Chiniklas/kinematic_chain/docs/sylink/image.png

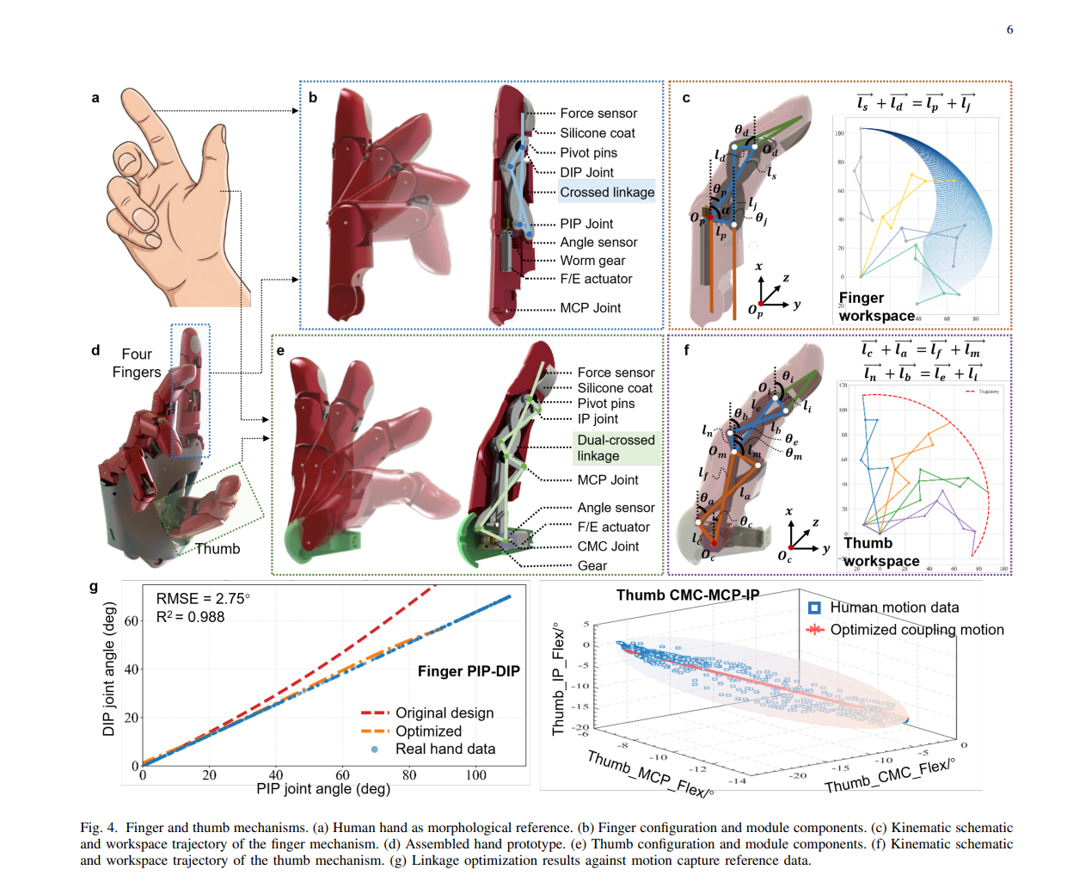
docs/sylink/image.png
