Chiniklas/kinematic_chain/src/co-optimization/config/objectives/little.jpg

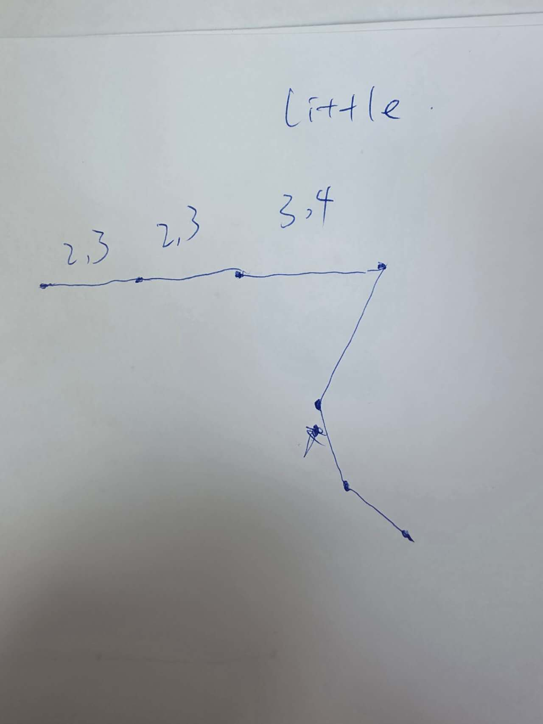
src/co-optimization/config/objectives/little.jpg
