Chiniklas/kinematic_chain/designs/mechanism_2/nominal/artifacts/mechanism/torque/torque_samples.csv

q_deg | input_torque_Nm | input_torque_mNm | body:input_crank_Nm | body:loop_1_coupler_Nm | body:central_body_Nm | body:link_ef_Nm | body:distal_body_Nm | point:joint_b_Nm | point:joint_c_Nm | point:joint_f_Nm | point:joint_g_Nm
0 | -0.00886217412428 | -8.86217412428 | -1.25856304545e-10 | 1.81010883658e-06 | -0.00144303711405 | -0.000202475854404 | -0.00438019748464 | -1.5102758627e-10 | 2.71531428237e-06 | -0.00121485512642 | -0.001626133691
0.5 | -0.00891306620988 | -8.91306620988 | -6.63221682809e-06 | -9.37021541994e-06 | -0.00145834228641 | -0.000201048663018 | -0.00438278547706 | -7.95866019371e-06 | -6.09666293624e-06 | -0.00120629197811 | -0.00163454004991
1 | -0.00896341870421 | -8.96341870421 | -1.32639288644e-05 | -2.05497326343e-05 | -0.00147359110225 | -0.000199607366445 | -0.00438505401288 | -1.59167146373e-05 | -1.49078843142e-05 | -0.00119764419867 | -0.00164288376351
1.5 | -0.00901269168418 | -9.01269168418 | -1.98946306651e-05 | -3.17271150897e-05 | -0.00148872633648 | -0.000198138131604 | -0.00438668432056 | -2.38735567981e-05 | -2.37171158364e-05 | -0.00118882878962 | -0.00165110168752
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
