Chiniklas/kinematic_chain/designs/mechanism_2/nominal/artifacts/mechanism/workspace/workspace_samples.csv

q_deg | max_residual_mm | a_x_mm | a_y_mm | b_x_mm | b_y_mm | c_x_mm | c_y_mm | d_x_mm | d_y_mm | e_x_mm | e_y_mm | f_x_mm | f_y_mm | g_x_mm | g_y_mm | h_x_mm | h_y_mm
0 | 1.00750335e-06 | 0 | 0 | 0 | 31 | 53.916595 | 27.999876 | 54 | 0 | 65.518519 | 7.957621 | 94.718773 | 1.076843 | 103.914329 | 27.523804 | 150.932098 | 10.514118
0.5 | 1.349514633e-08 | 0 | 0 | 0.2705226002 | 30.99881962 | 54.18715574 | 27.99937451 | 54 | 0 | 65.518519 | 7.957621 | 94.63182167 | 0.7177585297 | 104.1779549 | 27.0402079 | 150.9655731 | 9.407318576
1 | 1.355390111e-08 | 0 | 0 | 0.5410245992 | 30.99527855 | 54.45768142 | 27.99625917 | 54 | 0 | 65.518519 | 7.957621 | 94.54083115 | 0.3612140897 | 104.4368794 | 26.55411827 | 150.9853744 | 8.299321162
1.5 | 1.361586754e-08 | 0 | 0 | 0.8114853972 | 30.98937707 | 54.72815183 | 27.99053045 | 54 | 0 | 65.518519 | 7.957621 | 94.44587213 | 0.007259887298 | 104.6910835 | 26.06557229 | 150.9914609 | 7.190322661
2 | 1.36813938e-08 | 0 | 0 | 1.081884397 | 30.98111564 | 54.99854639 | 27.98218907 | 54 | 0 | 65.518519 | 7.957621 | 94.34701495 | -0.344054839 | 104.9405483 | 25.57460741 | 150.9837949 | 6.080520042
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
