Chiniklas/kinematic_chain/designs/mechanism_2/nominal/artifacts/combined/fingers/index/combined_workspace_samples.csv

finger | q_deg | curl_progress | h_x_mm | h_y_mm | hand_mcp_x_mm | hand_mcp_y_mm | hand_pip_x_mm | hand_pip_y_mm | hand_dip_x_mm | hand_dip_y_mm | hand_tip_x_mm | hand_tip_y_mm | distal_start_x_mm | distal_start_y_mm | distal_end_x_mm | distal_end_y_mm | r4_x_mm | r4_y_mm | rod_length_mm | rod_error_mm | perpendicular_deviation_deg | mechanism_residual_mm
index | 0.0 | 0.0 | 96.932098 | 10.514118 | 0.0 | -2.0 | 40.0 | -2.0 | 65.0 | -2.0 | 90.0 | -2.0 | 65.0 | -2.0 | 90.0 | -2.0 | 77.5 | -2.0 | 28.0 | 4.88702567821424 | 57.21878387128254 | 1.0075033500811514e-06
index | 0.5 | 0.007633587786259542 | 96.96557307365543 | 9.407318575703622 | 0.0 | -2.0 | 39.999248798505036 | -2.24514394810717 | 64.99641564020598 | -2.621507984868039 | 89.99206687823877 | -3.087790288445934 | 64.99641564020598 | -2.621507984868039 | 89.99206687823877 | -3.087790288445934 | 77.49424125922238 | -2.8546491366569864 | 28.0 | 4.989380390638608 | 56.730843304965525 | 1.3495146333752928e-08
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
