Chiniklas/kinematic_chain/designs/mechanism_2/nominal/artifacts/combined/fingers/little/combined_workspace_samples.csv

finger | q_deg | curl_progress | h_x_mm | h_y_mm | hand_mcp_x_mm | hand_mcp_y_mm | hand_pip_x_mm | hand_pip_y_mm | hand_dip_x_mm | hand_dip_y_mm | hand_tip_x_mm | hand_tip_y_mm | distal_start_x_mm | distal_start_y_mm | distal_end_x_mm | distal_end_y_mm | r4_x_mm | r4_y_mm | rod_length_mm | rod_error_mm | perpendicular_deviation_deg | mechanism_residual_mm
little | 0.0 | 0.0 | 96.932098 | 10.514118 | 0.0 | -2.0 | 34.0 | -2.0 | 57.0 | -2.0 | 80.0 | -2.0 | 57.0 | -2.0 | 80.0 | -2.0 | 68.5 | -2.0 | 28.0 | 3.0642454600063935 | 66.24376121835917 | 1.0075033500811514e-06
little | 0.5 | 0.007633587786259542 | 96.96557307365543 | 9.407318575703622 | 0.0 | -2.0 | 33.99872507374635 | -2.2944373614393214 | 56.99629983025596 | -2.6284363416054677 | 79.99212567188638 | -3.066607382869641 | 56.99629983025596 | -2.6284363416054677 | 79.99212567188638 | -3.066607382869641 | 68.49421275107117 | -2.8475218622375547 | 28.0 | 2.996765521225335 | 65.62005078098242 | 1.3495146333752928e-08
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
