Chiniklas/kinematic_chain/designs/mechanism_2/nominal/artifacts/combined/fingers/middle/combined_workspace_samples.csv

finger | q_deg | curl_progress | h_x_mm | h_y_mm | hand_mcp_x_mm | hand_mcp_y_mm | hand_pip_x_mm | hand_pip_y_mm | hand_dip_x_mm | hand_dip_y_mm | hand_tip_x_mm | hand_tip_y_mm | distal_start_x_mm | distal_start_y_mm | distal_end_x_mm | distal_end_y_mm | r4_x_mm | r4_y_mm | rod_length_mm | rod_error_mm | perpendicular_deviation_deg | mechanism_residual_mm
middle | 0.0 | 0.0 | 96.932098 | 10.514118 | 0.0 | -2.0 | 49.0 | -2.0 | 76.0 | -2.0 | 103.0 | -2.0 | 76.0 | -2.0 | 103.0 | -2.0 | 89.5 | -2.0 | 28.0 | 13.445302133004343 | 30.705952228880232 | 1.0075033500811514e-06
middle | 0.5 | 0.007633587786259542 | 96.96557307365543 | 9.407318575703622 | 0.0 | -2.0 | 48.999404638431415 | -2.2415472609362204 | 75.99618020625371 | -2.658810895384777 | 102.99128010729812 | -3.173185595999241 | 75.99618020625371 | -2.658810895384777 | 102.99128010729812 | -3.173185595999241 | 89.49373015677591 | -2.915998245692009 | 28.0 | 13.588456916241924 | 30.13756429501541 | 1.3495146333752928e-08
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
