Chiniklas/kinematic_chain/designs/mechanism_2/nominal/artifacts/combined/fingers/ring/combined_workspace_samples.csv

finger | q_deg | curl_progress | h_x_mm | h_y_mm | hand_mcp_x_mm | hand_mcp_y_mm | hand_pip_x_mm | hand_pip_y_mm | hand_dip_x_mm | hand_dip_y_mm | hand_tip_x_mm | hand_tip_y_mm | distal_start_x_mm | distal_start_y_mm | distal_end_x_mm | distal_end_y_mm | r4_x_mm | r4_y_mm | rod_length_mm | rod_error_mm | perpendicular_deviation_deg | mechanism_residual_mm
ring | 0.0 | 0.0 | 96.932098 | 10.514118 | 0.0 | -2.0 | 44.0 | -2.0 | 70.0 | -2.0 | 96.0 | -2.0 | 70.0 | -2.0 | 96.0 | -2.0 | 83.0 | -2.0 | 28.0 | 9.27284047166982 | 48.06911766849675 | 1.0075033500811514e-06
ring | 0.5 | 0.007633587786259542 | 96.96557307365543 | 9.407318575703622 | 0.0 | -2.0 | 43.99940603198138 | -2.228623780130022 | 69.99749515397887 | -2.543841172853755 | 95.99290760251141 | -3.0322381739498736 | 69.99749515397887 | -2.543841172853755 | 95.99290760251141 | -3.0322381739498736 | 82.99520137824514 | -2.7880396734018142 | 28.0 | 9.455511650845011 | 47.80451143116388 | 1.3495146333752928e-08
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
