Chiniklas/kinematic_chain/designs/mechanism_2/nominal/artifacts/combined/combined_abstraction.png

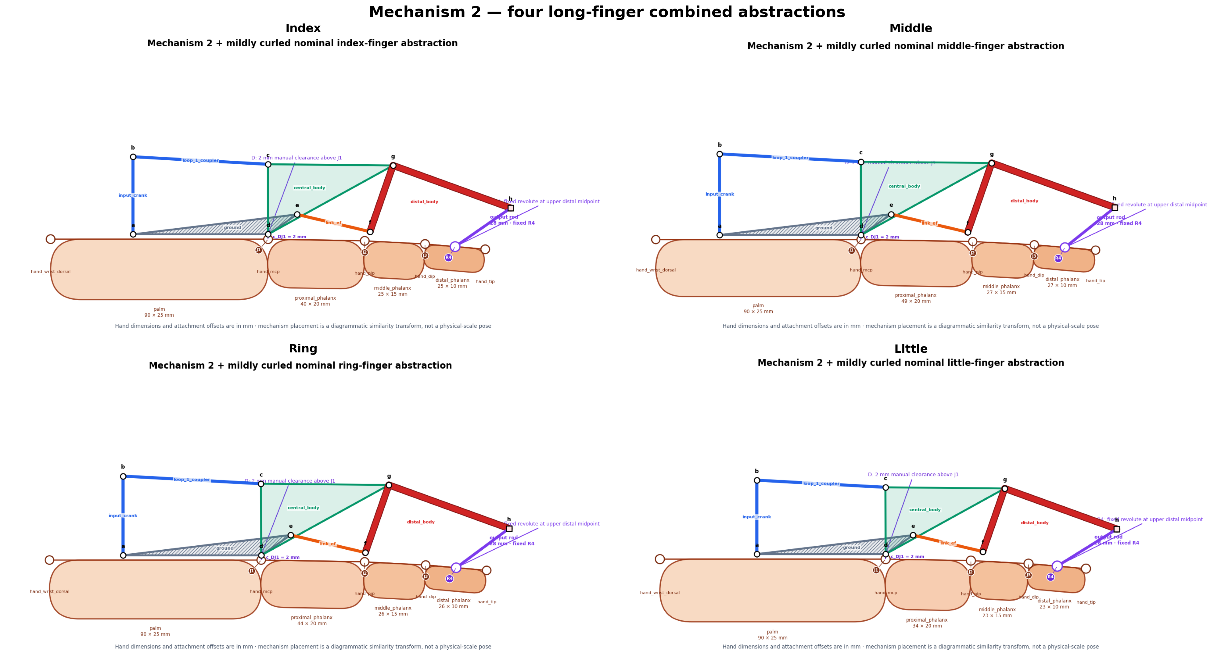
designs/mechanism_2/nominal/artifacts/combined/combined_abstraction.png
