Chiniklas/kinematic_chain/designs/mechanism_2/nominal/artifacts/combined/combined_workspace_report.png

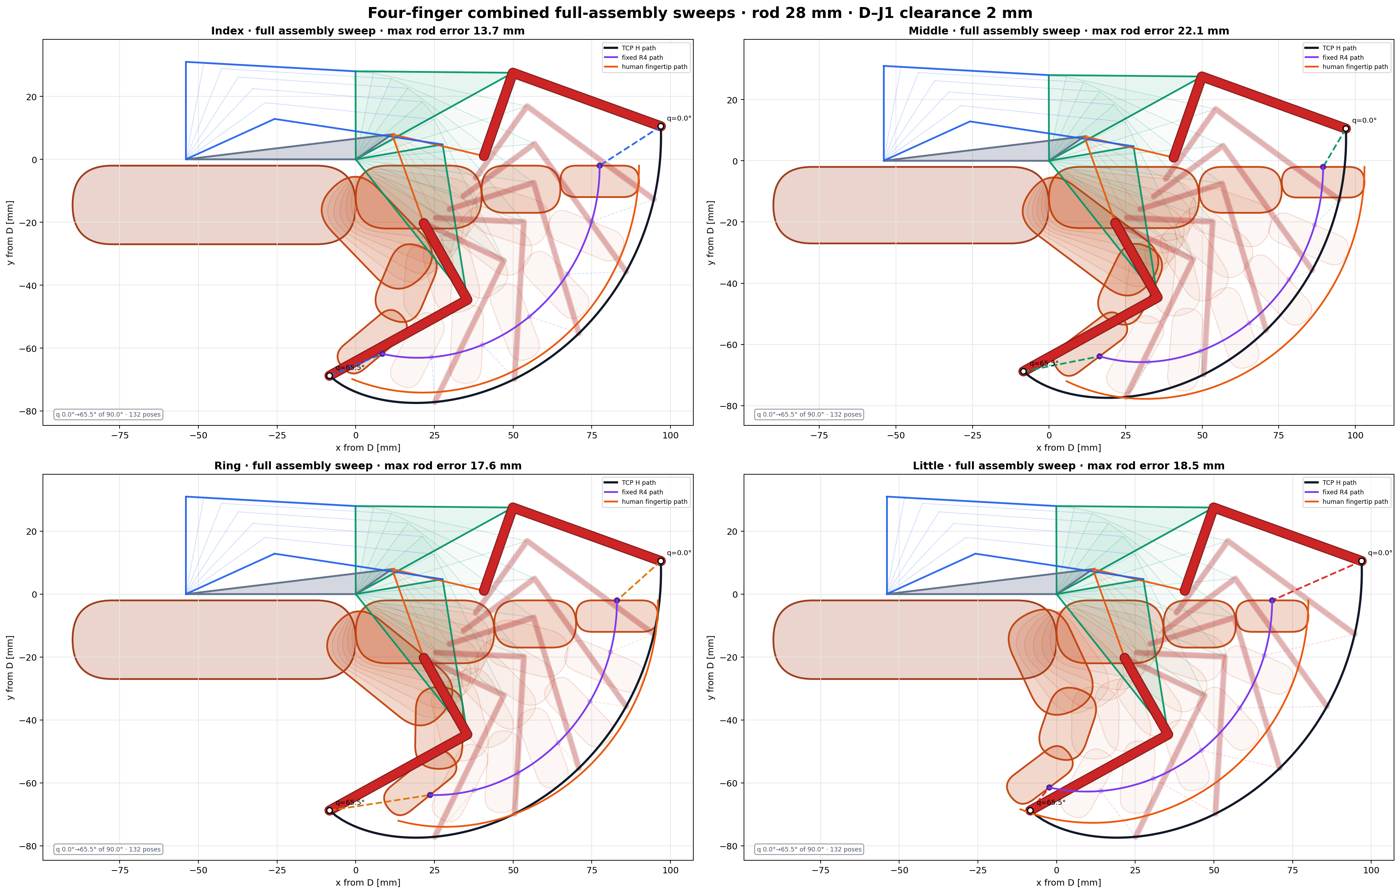
designs/mechanism_2/nominal/artifacts/combined/combined_workspace_report.png
