Chiniklas/kinematic_chain/designs/mechanism_2/nominal/artifacts/combined/fingers/index/combined_abstraction.png

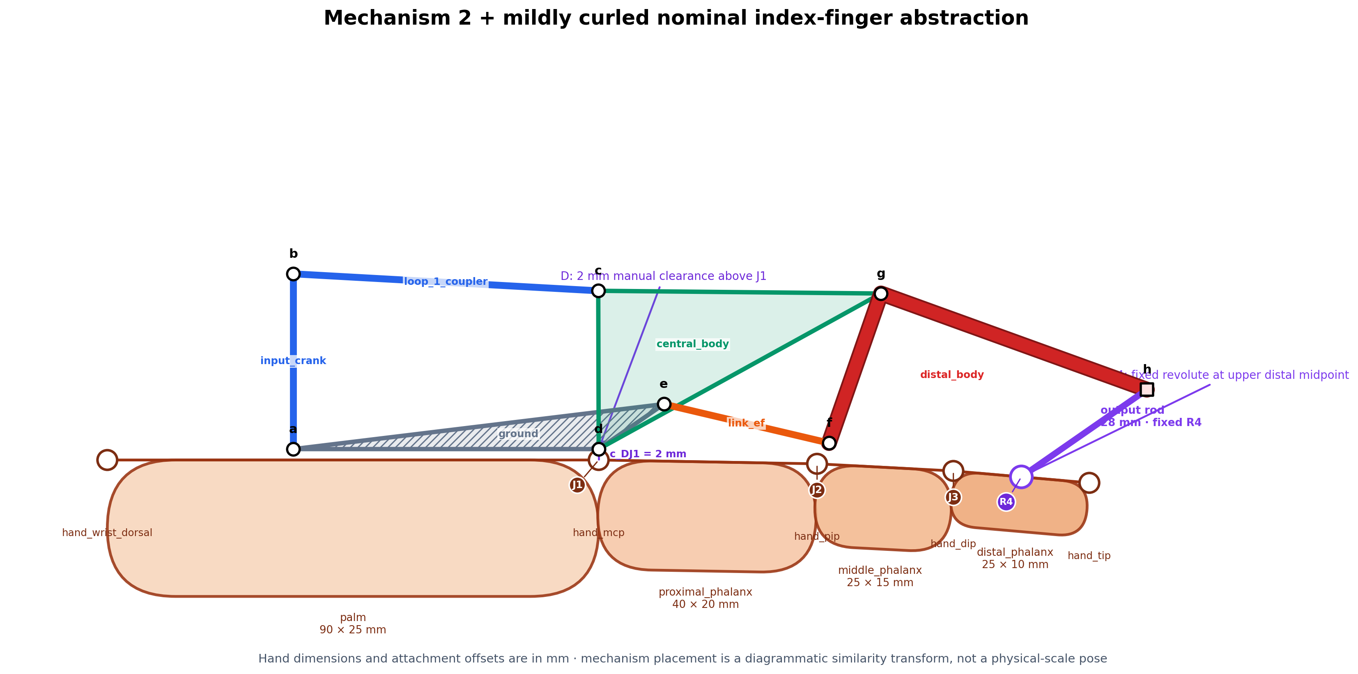
designs/mechanism_2/nominal/artifacts/combined/fingers/index/combined_abstraction.png
