Chiniklas/kinematic_chain/designs/mechanism_2/nominal/artifacts/combined/fingers/little/combined_abstraction.png

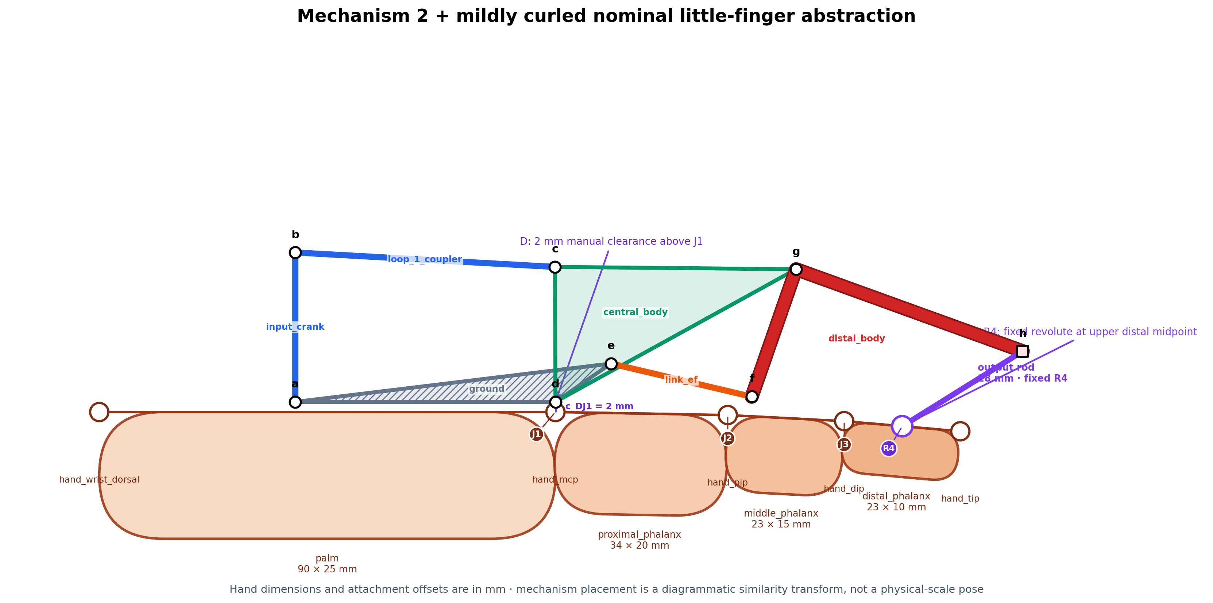
designs/mechanism_2/nominal/artifacts/combined/fingers/little/combined_abstraction.png
