Chiniklas/kinematic_chain/designs/mechanism_2/nominal/artifacts/mechanism/abstraction.png

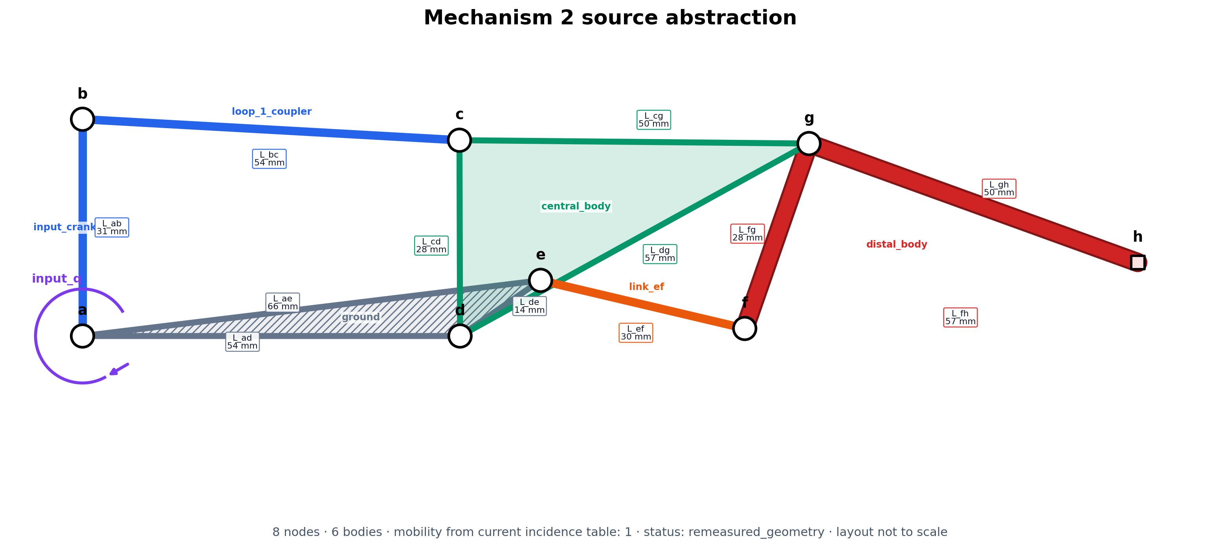
designs/mechanism_2/nominal/artifacts/mechanism/abstraction.png
