Chiniklas/kinematic_chain/designs/mechanism_2/nominal/artifacts/mechanism/torque/torque_report.png

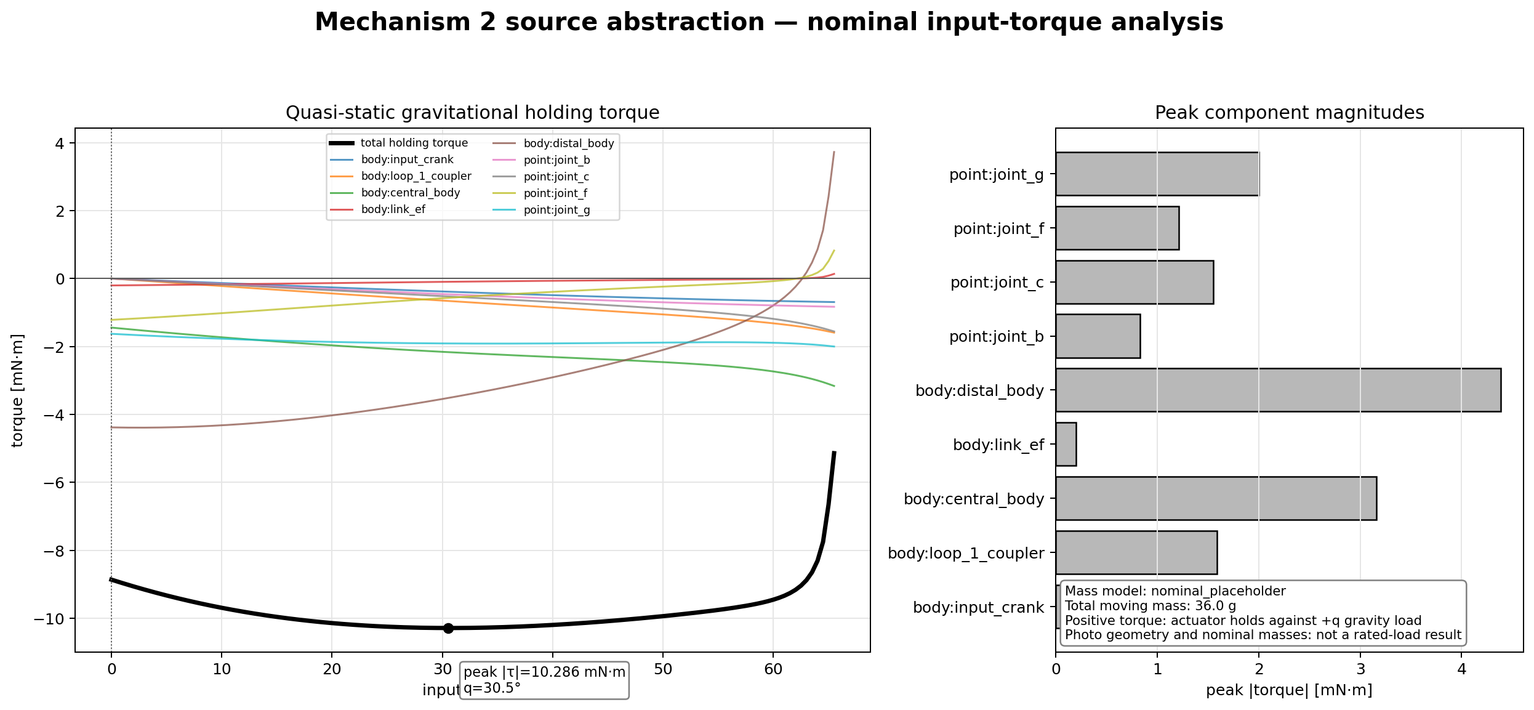
designs/mechanism_2/nominal/artifacts/mechanism/torque/torque_report.png
