Chiniklas/kinematic_chain/designs/mechanism_2/nominal/artifacts/mechanism/workspace/workspace_report.png

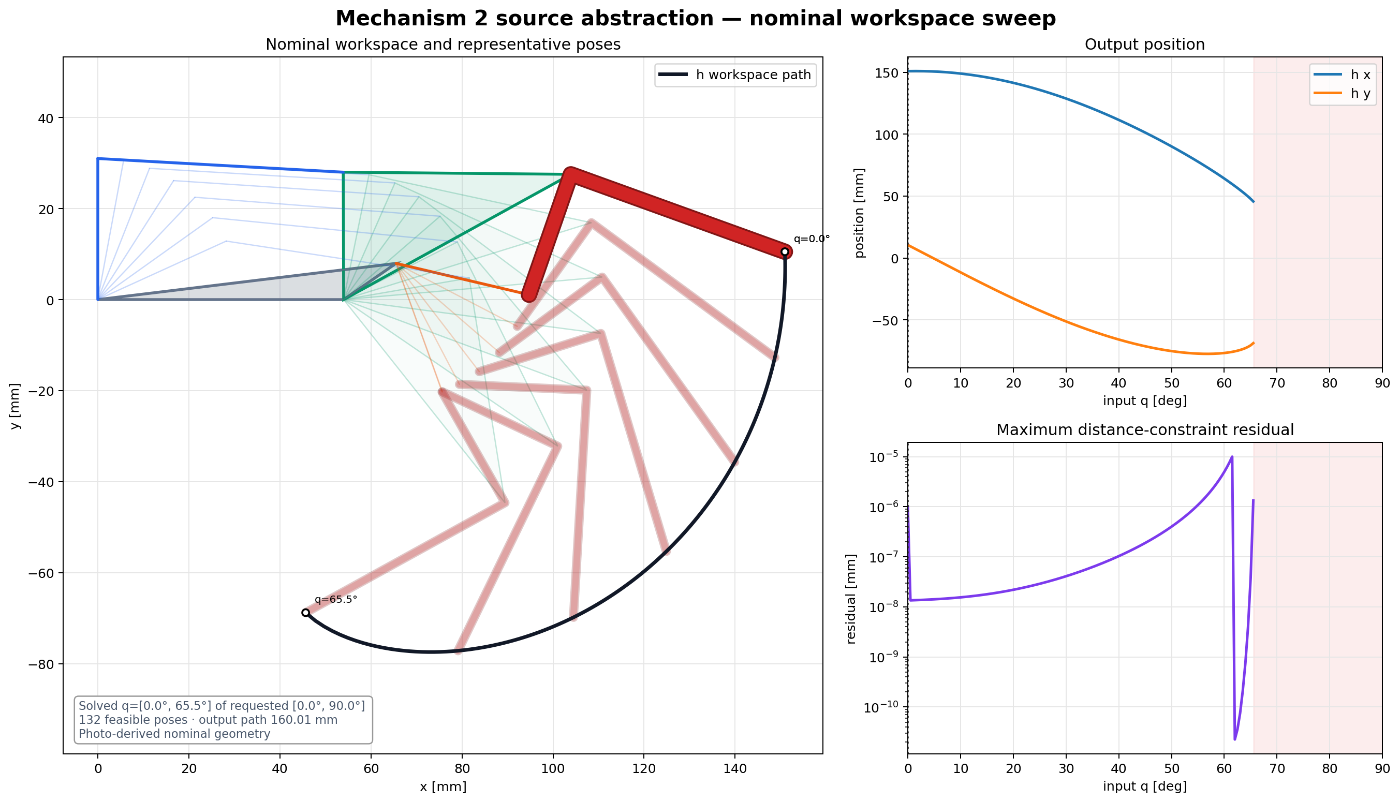
designs/mechanism_2/nominal/artifacts/mechanism/workspace/workspace_report.png
