Chiniklas/kinematic_chain/designs/mechanism_2/nominal/sources/abstraction.jpg

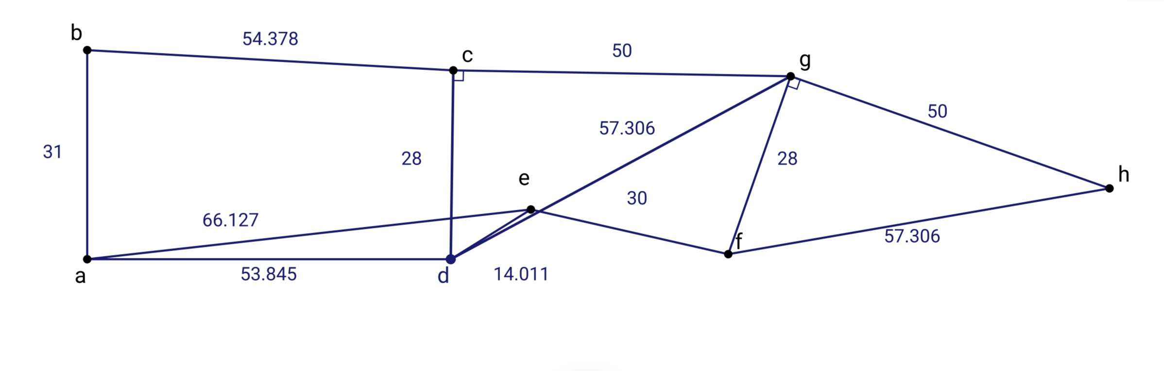
designs/mechanism_2/nominal/sources/abstraction.jpg
