Chiniklas/kinematic_chain/docs/candidates/compare_short_vs_long.gif

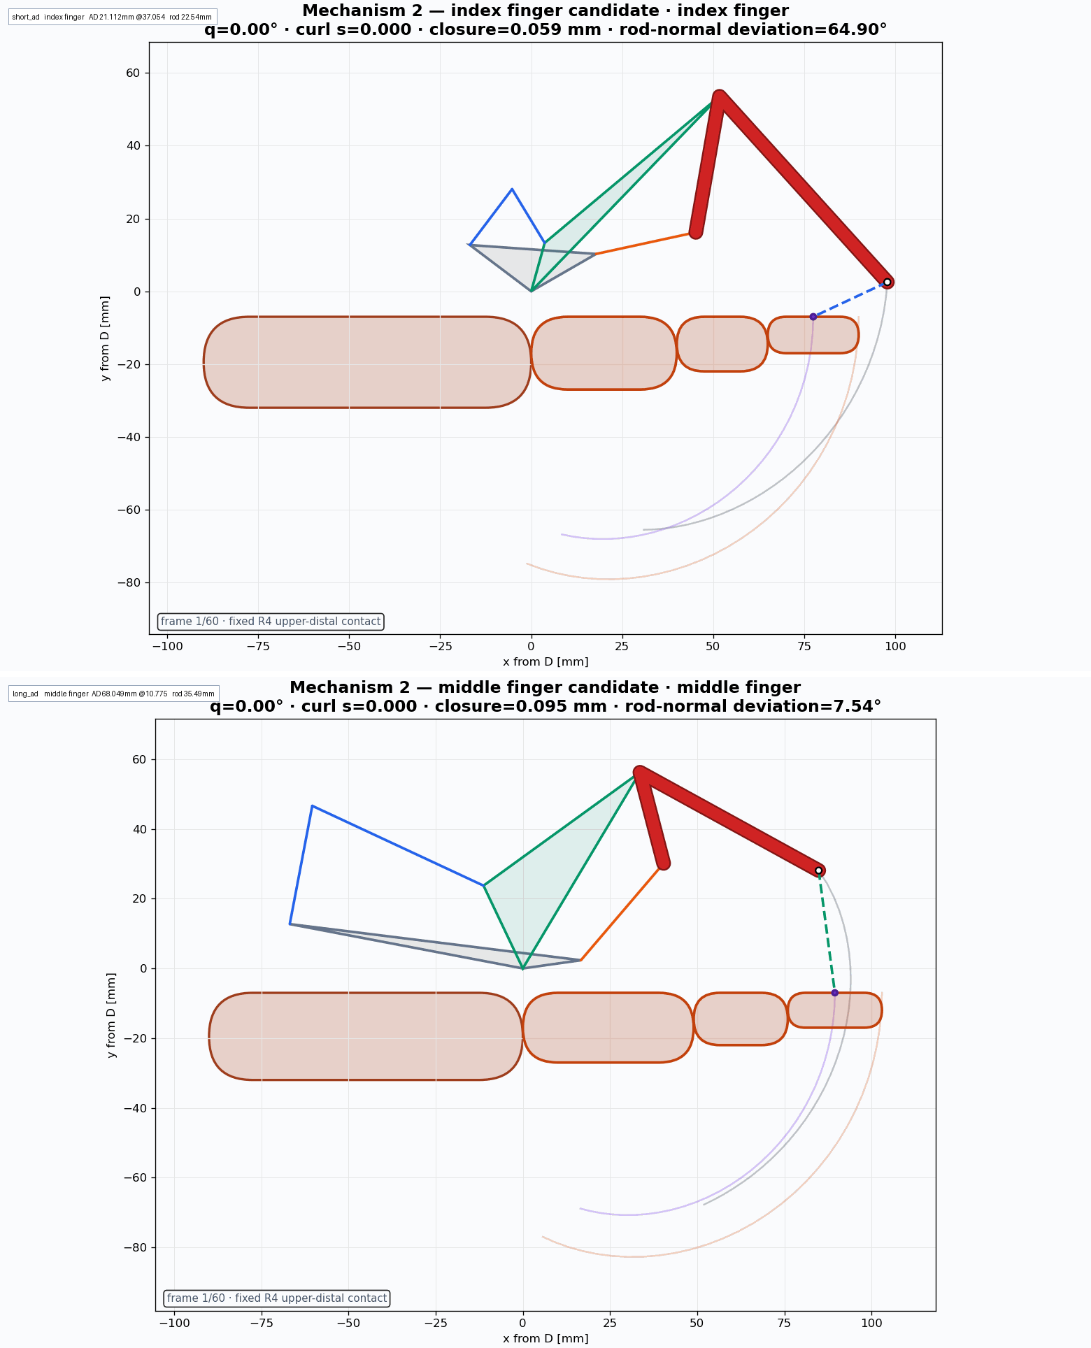
docs/candidates/compare_short_vs_long.gif
