Chiniklas/kinematic_chain/docs/candidates/index_finger_tilted_v2/design_animation.gif

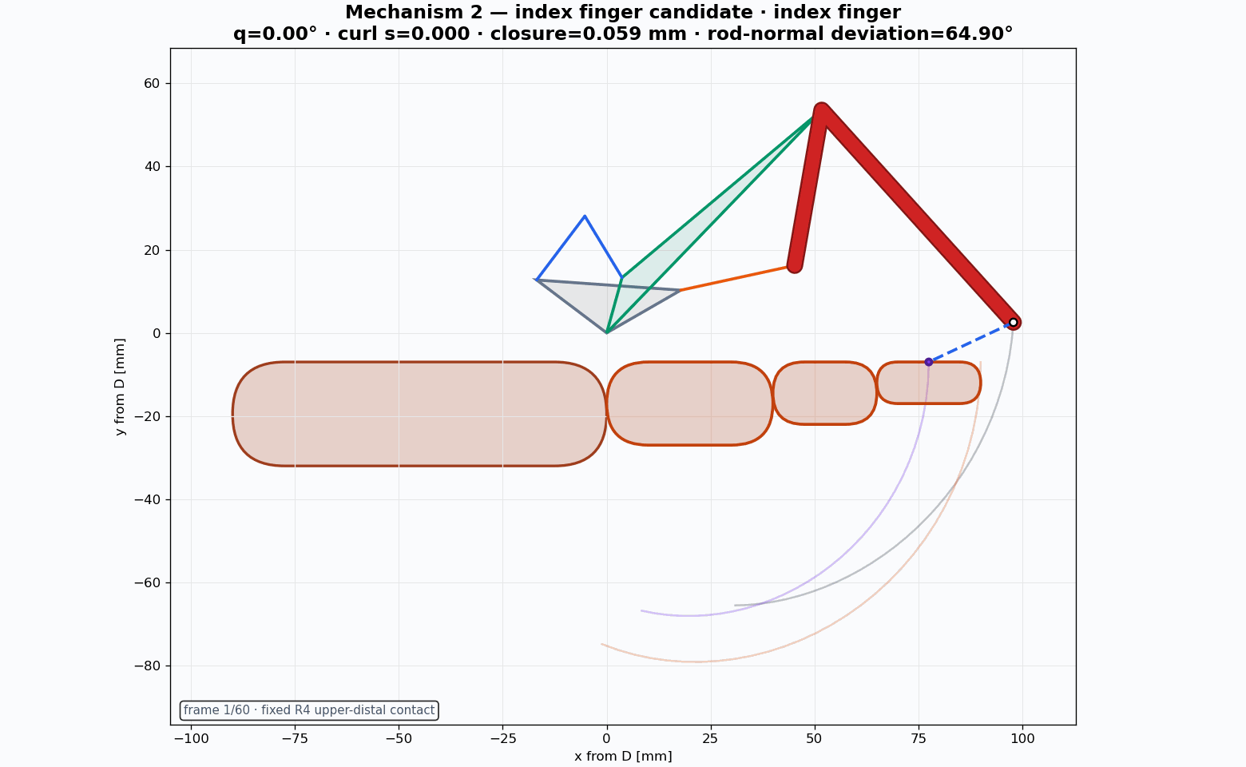
docs/candidates/index_finger_tilted_v2/design_animation.gif
