Chiniklas/kinematic_chain/docs/candidates/index_finger_v1/abstraction.png

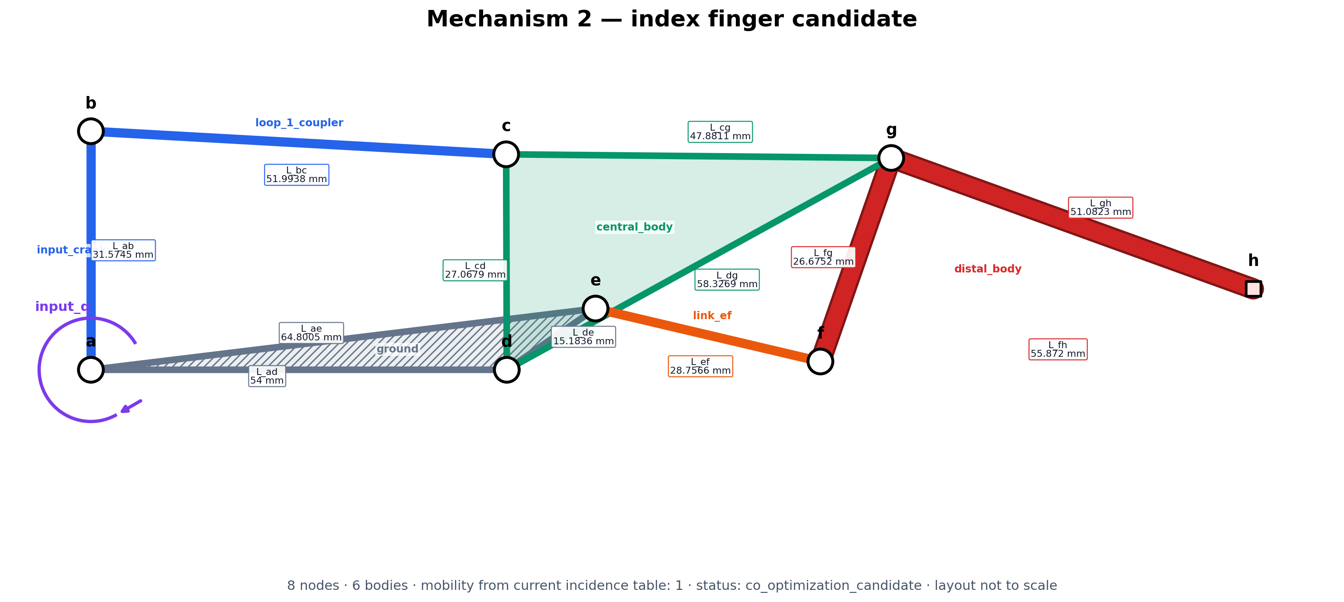
docs/candidates/index_finger_v1/abstraction.png
