Chiniklas/kinematic_chain/docs/candidates/index_finger_v1/combined_workspace_report.png

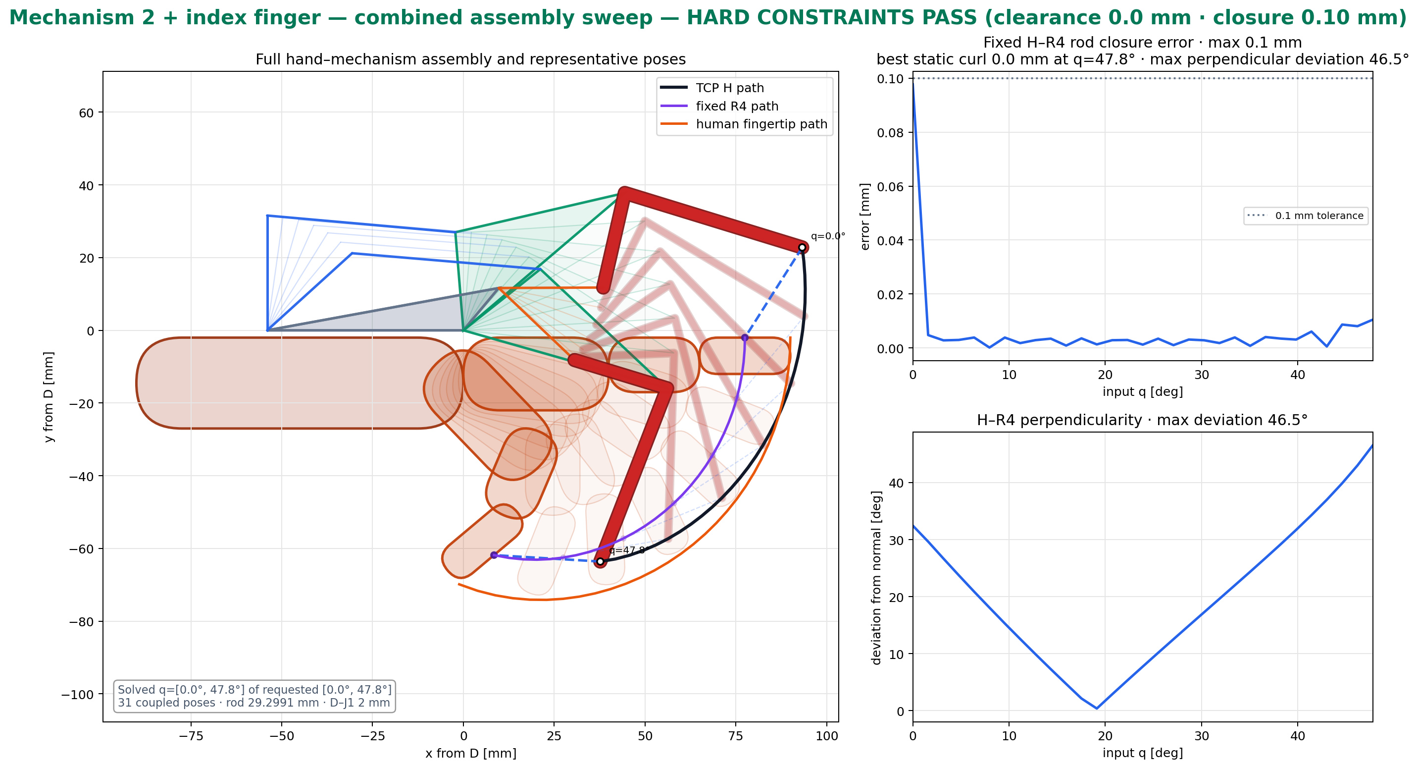
docs/candidates/index_finger_v1/combined_workspace_report.png
