Chiniklas/kinematic_chain/docs/candidates/index_finger_v1/design_animation.gif

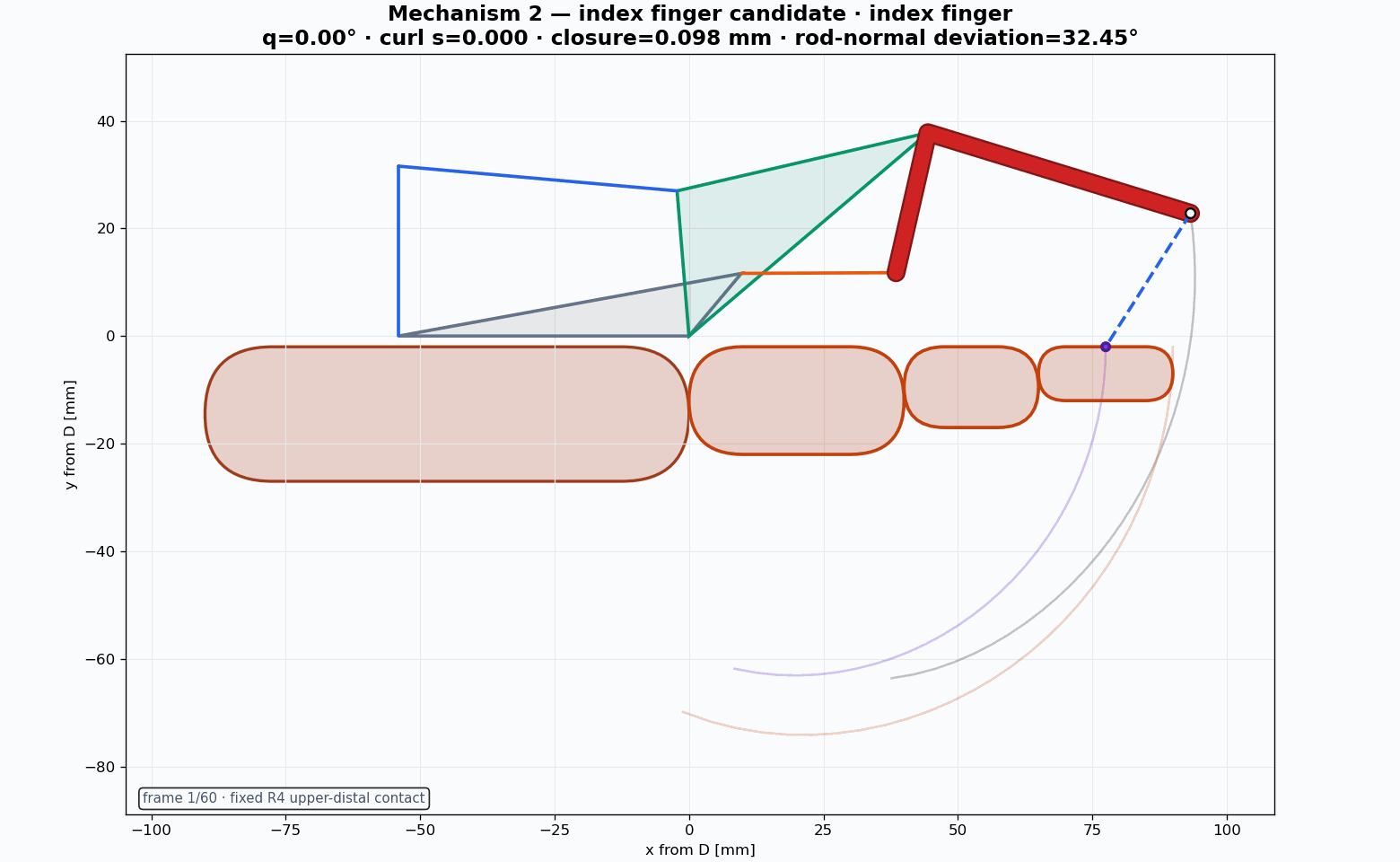
docs/candidates/index_finger_v1/design_animation.gif
