Chiniklas/kinematic_chain/docs/candidates/middle_finger_long_ad/design_animation.gif

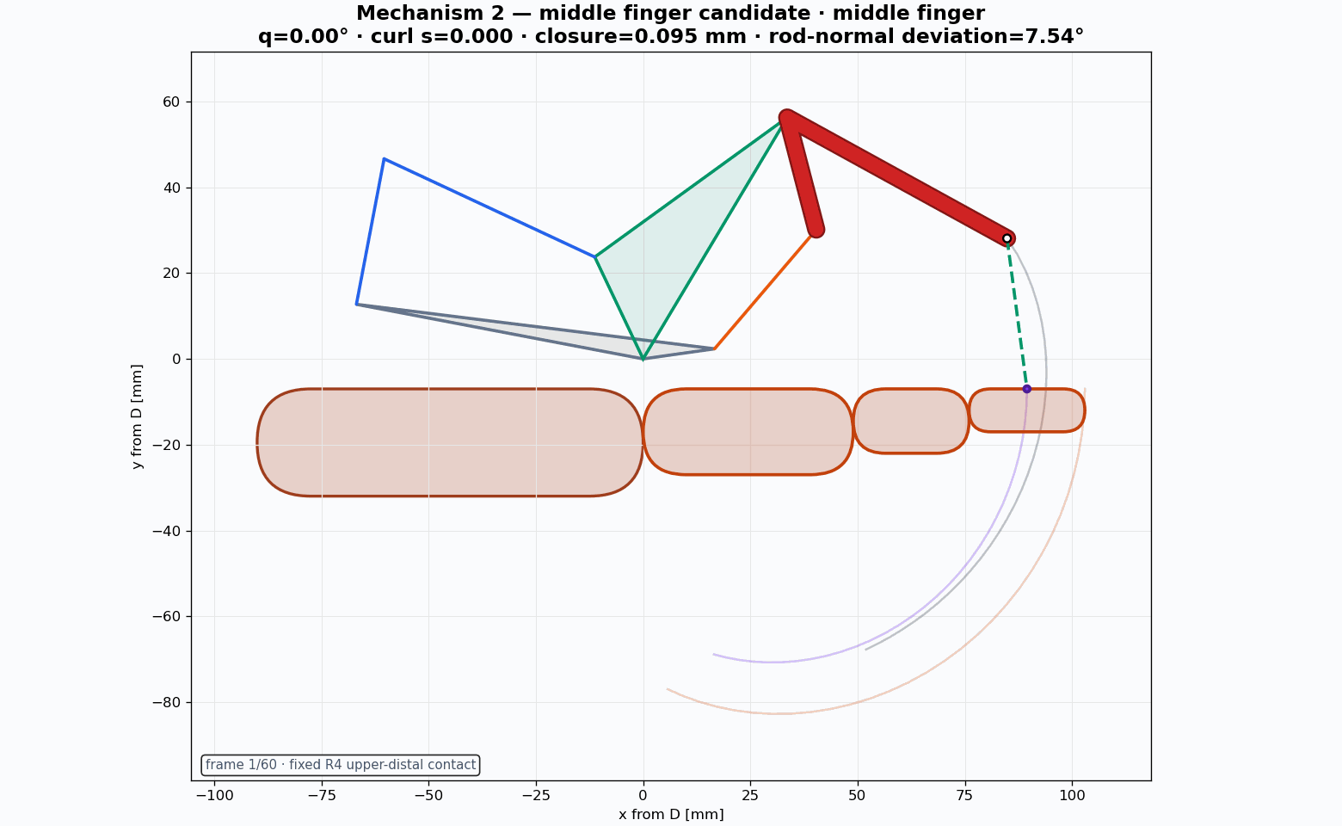
docs/candidates/middle_finger_long_ad/design_animation.gif
