Chiniklas/kinematic_chain/docs/candidates/thumb_direct/preview_exploded.png

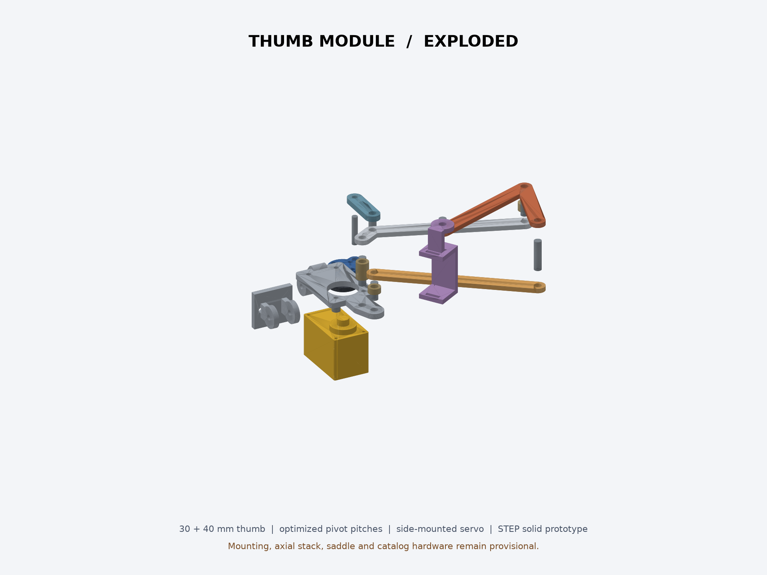
docs/candidates/thumb_direct/preview_exploded.png
