Chiniklas/kinematic_chain/docs/candidates/thumb_direct/preview_full_curl.png

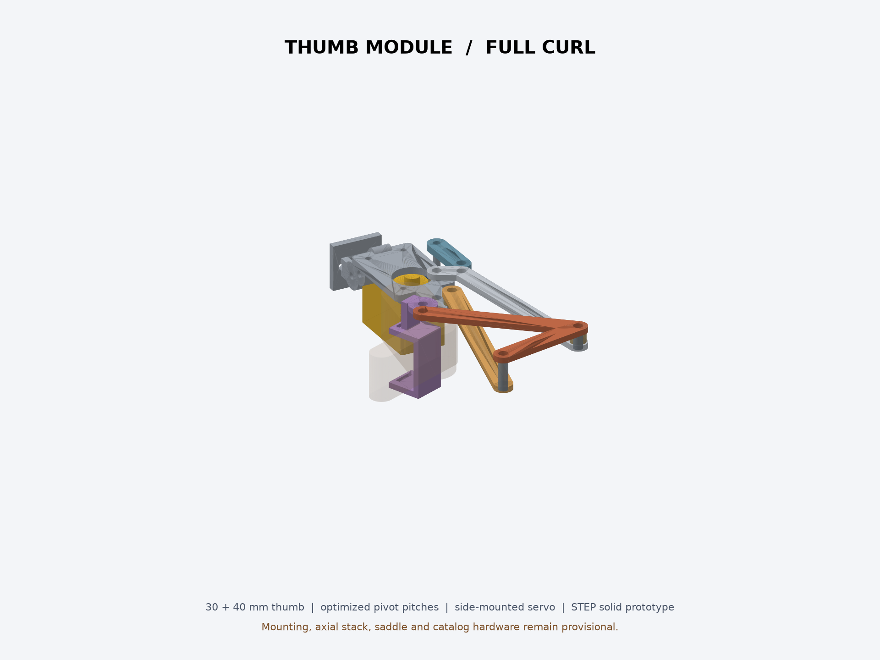
docs/candidates/thumb_direct/preview_full_curl.png
