Chiniklas/kinematic_chain/docs/candidates/thumb_direct/preview_straight.png

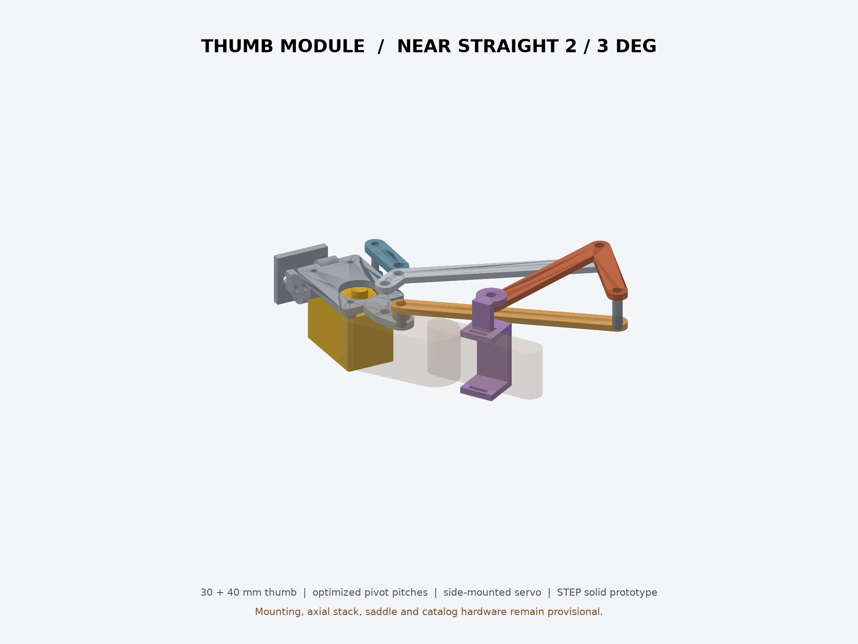
docs/candidates/thumb_direct/preview_straight.png
