Chiniklas/kinematic_chain/docs/candidates/thumb_direct/thumb_direct.gif

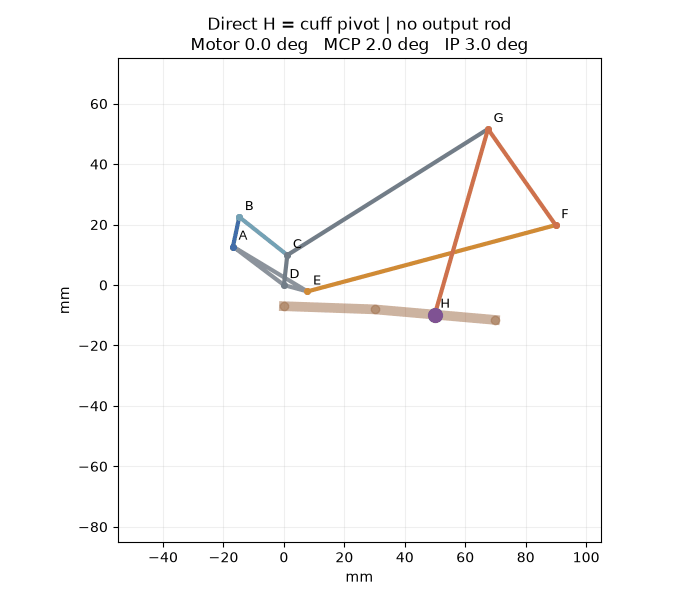
docs/candidates/thumb_direct/thumb_direct.gif
