Chiniklas/kinematic_chain/src/co-optimization/config/objectives/index.jpg

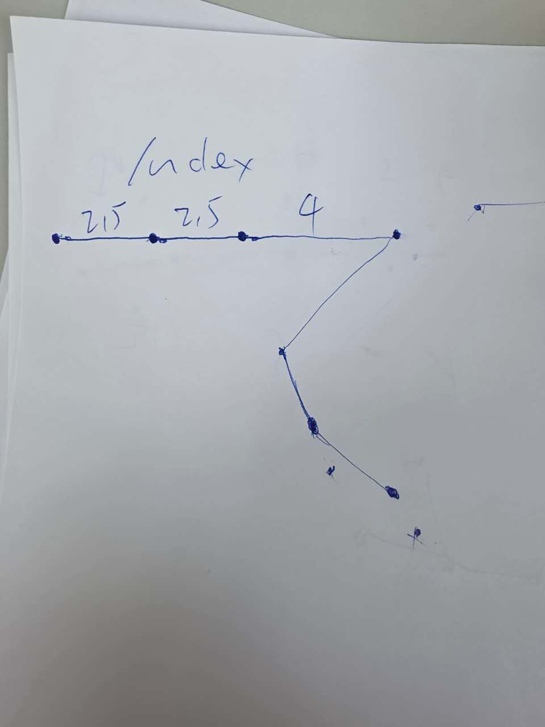
src/co-optimization/config/objectives/index.jpg
