Chiniklas/kinematic_chain/src/co-optimization/config/objectives/middle.jpg

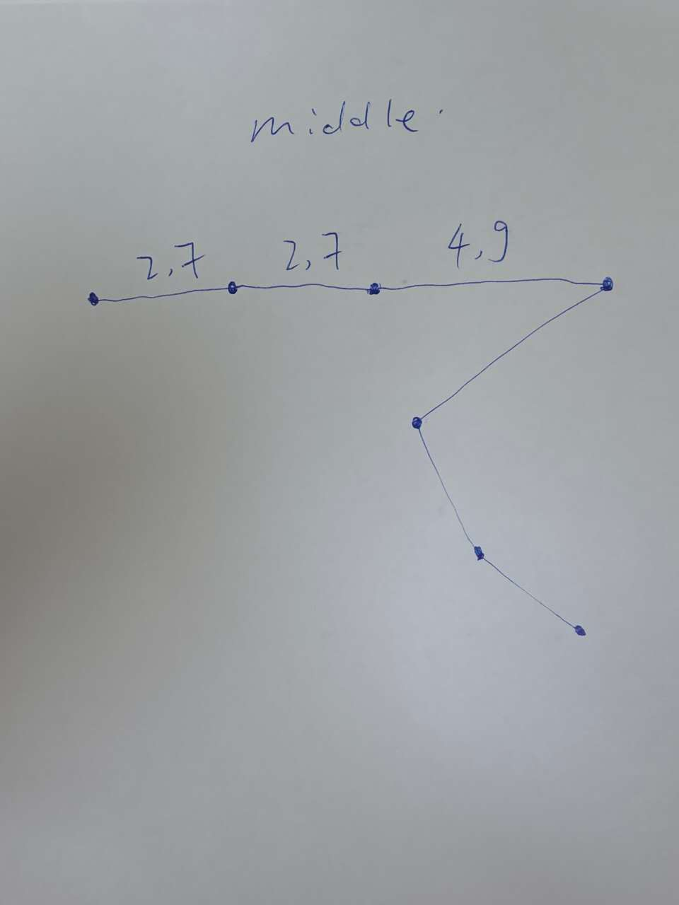
src/co-optimization/config/objectives/middle.jpg
