Chiniklas/kinematic_chain/src/co-optimization/config/objectives/ring.jpg

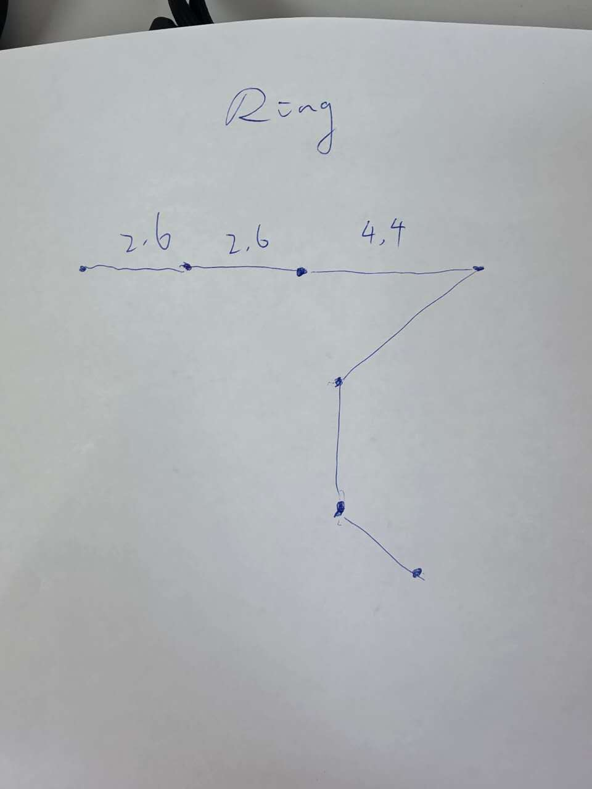
src/co-optimization/config/objectives/ring.jpg
