Chiniklas/kinematic_chain/docs/candidates/thumb_direct/parts/motor_standoff_3.step

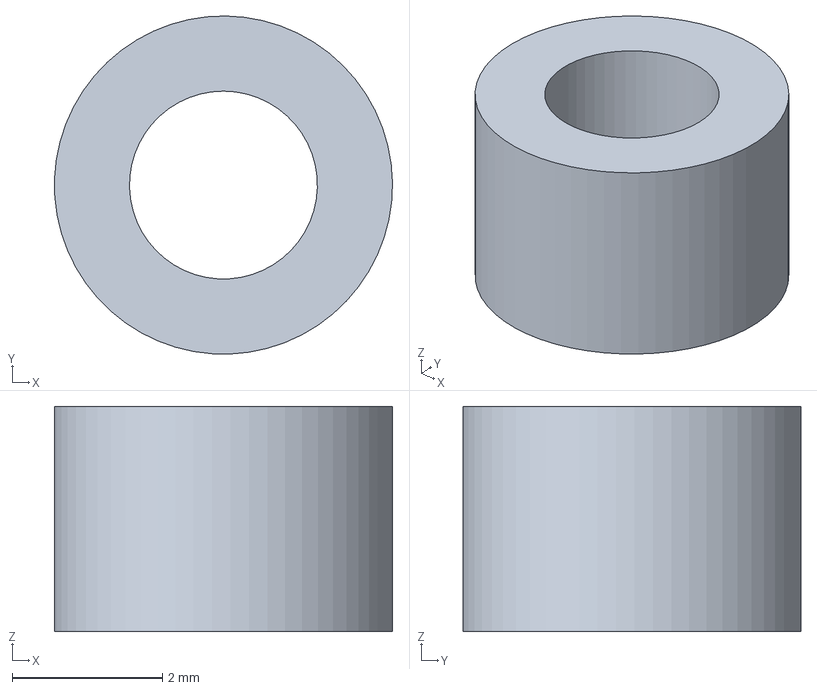
[picture p28: CAD file, 2026-11-09]
docs/candidates/thumb_direct/parts/motor_standoff_3.step
4.50 x 4.50 x 3.00 mm
