Chiniklas/kinematic_chain/docs/candidates/thumb_direct/parts/01_servo_carrier_ADE_and_hinge_rotor.step

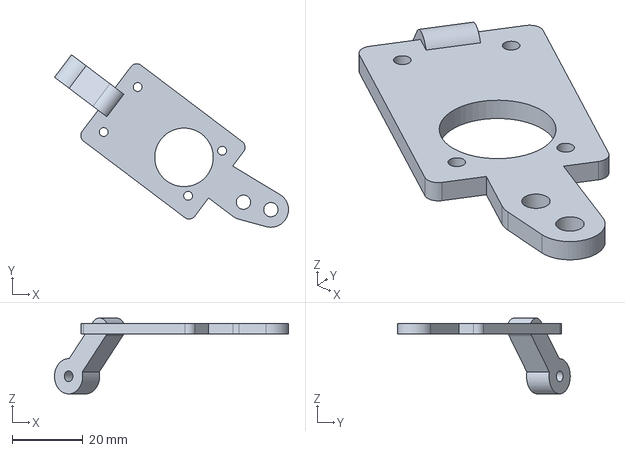
[picture p29: CAD file, 2026-11-09]
docs/candidates/thumb_direct/parts/01_servo_carrier_ADE_and_hinge_rotor.step
66.4 x 48.9 x 21.5 mm
