Chiniklas/kinematic_chain/docs/candidates/thumb_direct/parts/pin_E.step

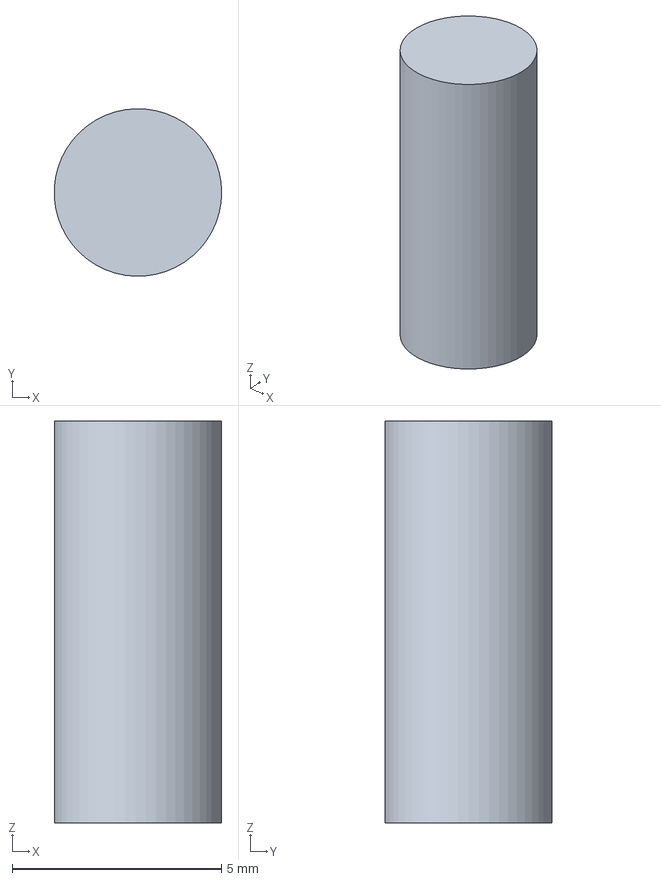
[picture p31: CAD file, 2026-11-09]
docs/candidates/thumb_direct/parts/pin_E.step
4.00 x 4.00 x 9.60 mm
