Chiniklas/kinematic_chain/docs/candidates/thumb_direct/parts/spacer_E.step

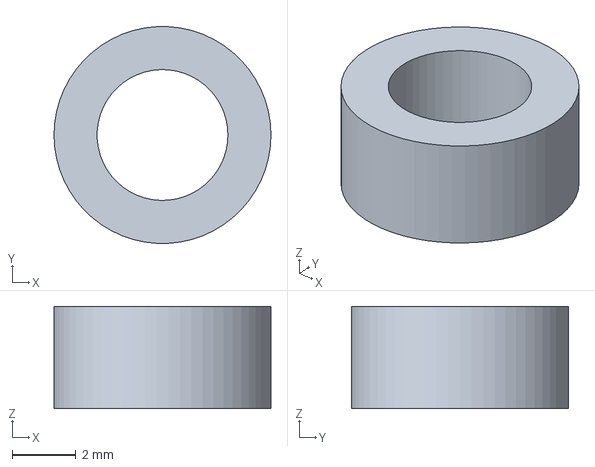
[picture p33: CAD file, 2026-11-09]
docs/candidates/thumb_direct/parts/spacer_E.step
6.80 x 6.79 x 3.20 mm
