Chiniklas/kinematic_chain/docs/candidates/thumb_direct/thumb_straight_with_reference.step

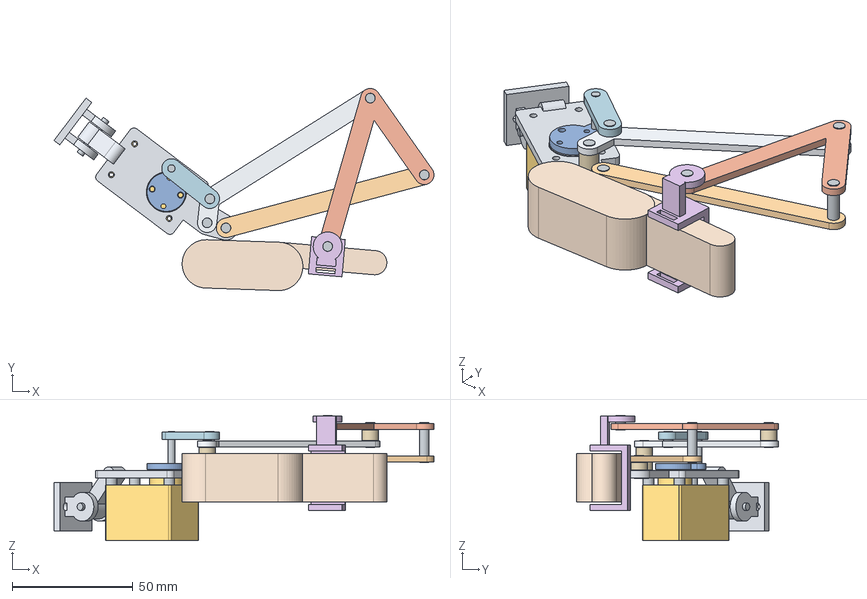
[picture p34: CAD file, 2026-11-09]
docs/candidates/thumb_direct/thumb_straight_with_reference.step
157.3 x 83.6 x 51.8 mm
01_servo_carrier_ADE_and_hinge_rotor
02_input_AB_servo_disc
03_coupler_BC
04_rocker_CDG
05_coupler_EF
06_output_FGH
08_distal_saddle_R4
09_DC15_A01_reference_envelope
10_servo_horn_reference
11_palm_hinge_clevis_interface
12_palm_hinge_pin
pin_B
pin_C
pin_D
pin_E
pin_F
pin_G
pin_H_direct_R4
spacer_D
spacer_E
spacer_G
motor_standoff_1
motor_standoff_2
motor_standoff_3
motor_standoff_4
REFERENCE_proximal
REFERENCE_distal
