Chiniklas/kinematic_chain/docs/candidates/thumb_direct/parts/pin_F.step

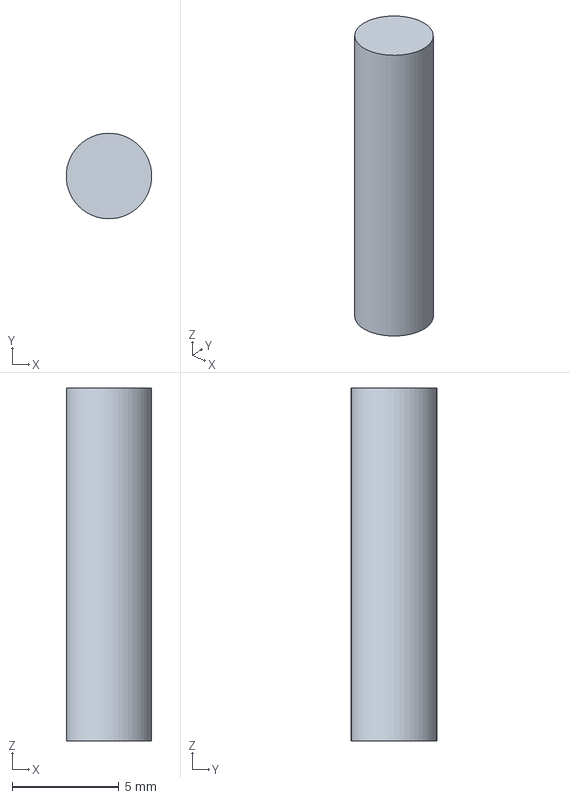
[picture p35: CAD file, 2026-11-09]
docs/candidates/thumb_direct/parts/pin_F.step
4.00 x 4.00 x 16.5 mm
