Chiniklas/kinematic_chain/docs/candidates/thumb_direct/parts/09_DC15_A01_reference_envelope.step

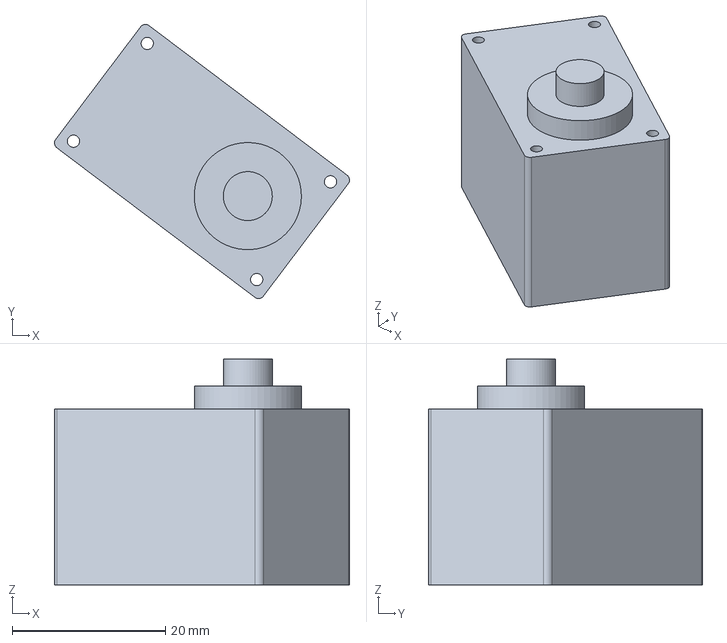
[picture p37: CAD file, 2026-11-09]
docs/candidates/thumb_direct/parts/09_DC15_A01_reference_envelope.step
38.5 x 35.8 x 29.5 mm
