Chiniklas/kinematic_chain/docs/candidates/thumb_direct/parts/12_palm_hinge_pin.step

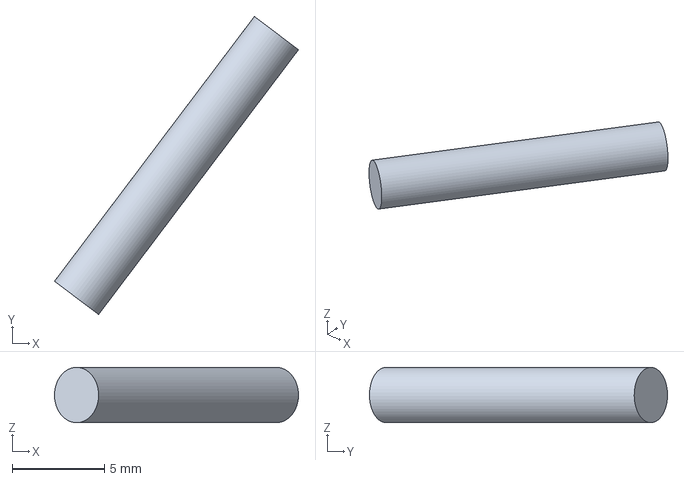
[picture p38: CAD file, 2026-11-09]
docs/candidates/thumb_direct/parts/12_palm_hinge_pin.step
13.2 x 16.2 x 3.00 mm
