Chiniklas/kinematic_chain/docs/candidates/thumb_direct/parts/04_rocker_CDG.step

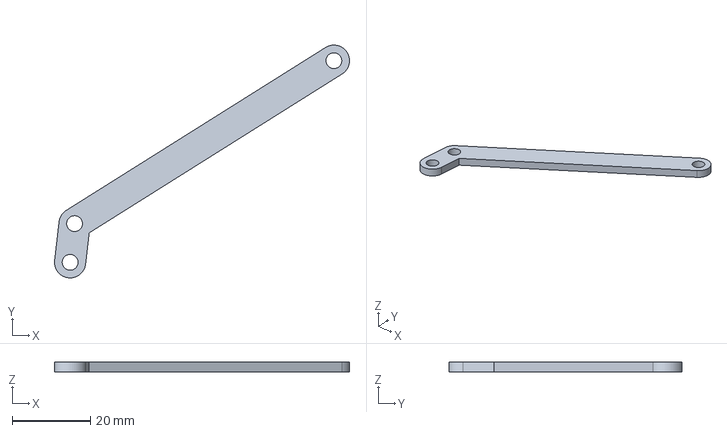
[picture p39: CAD file, 2026-11-09]
docs/candidates/thumb_direct/parts/04_rocker_CDG.step
75.5 x 59.6 x 2.50 mm
