Chiniklas/kinematic_chain/docs/candidates/thumb_direct/parts/pin_C.step

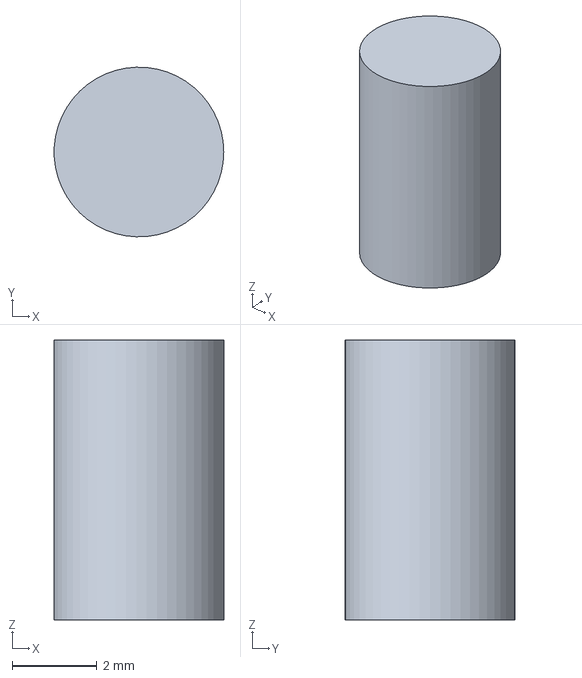
[picture p40: CAD file, 2026-11-09]
docs/candidates/thumb_direct/parts/pin_C.step
4.00 x 4.00 x 6.60 mm
