Chiniklas/kinematic_chain/docs/candidates/thumb_direct/parts/05_coupler_EF.step

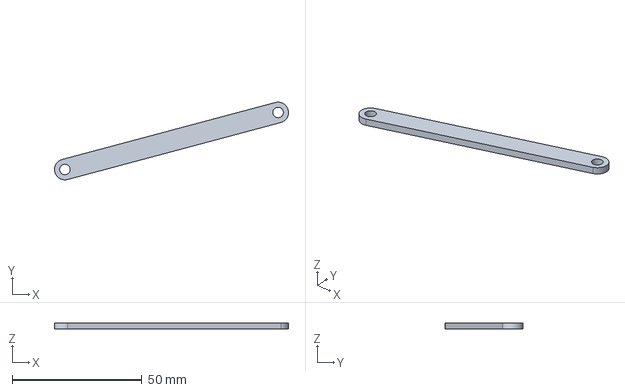
[picture p41: CAD file, 2026-11-09]
docs/candidates/thumb_direct/parts/05_coupler_EF.step
90.1 x 29.9 x 2.50 mm
