Chiniklas/kinematic_chain/docs/candidates/thumb_direct/parts/03_coupler_BC.step

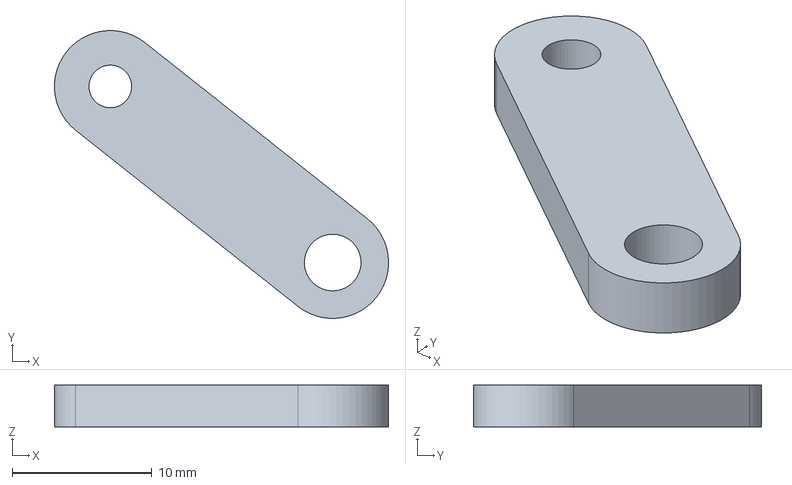
[picture p42: CAD file, 2026-11-09]
docs/candidates/thumb_direct/parts/03_coupler_BC.step
23.9 x 20.6 x 3.00 mm
