Chiniklas/kinematic_chain/docs/candidates/thumb_direct/parts/02_input_AB_servo_disc.step

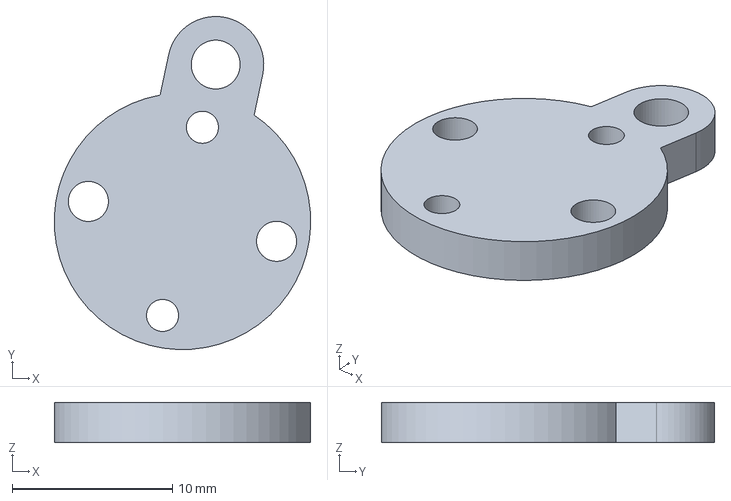
[picture p43: CAD file, 2026-11-09]
docs/candidates/thumb_direct/parts/02_input_AB_servo_disc.step
16.0 x 20.8 x 2.50 mm
