Chiniklas/kinematic_chain/docs/candidates/thumb_direct/parts/pin_G.step

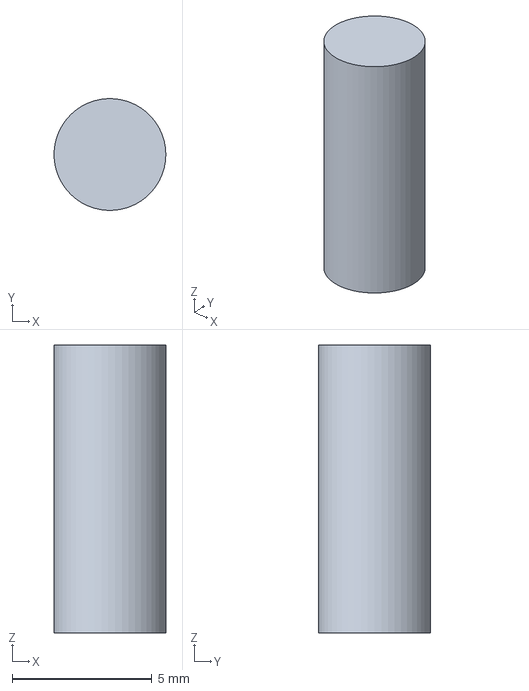
[picture p44: CAD file, 2026-11-09]
docs/candidates/thumb_direct/parts/pin_G.step
4.00 x 4.00 x 10.3 mm
