Chiniklas/kinematic_chain/docs/candidates/thumb_direct/parts/08_distal_saddle_R4.step

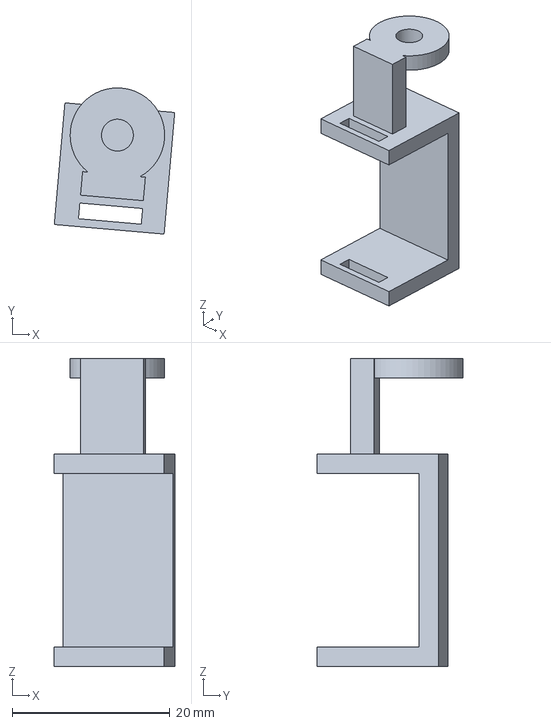
[picture p45: CAD file, 2026-11-09]
docs/candidates/thumb_direct/parts/08_distal_saddle_R4.step
15.3 x 18.6 x 39.1 mm
