Chiniklas/kinematic_chain/docs/candidates/thumb_direct/parts/11_palm_hinge_clevis_interface.step

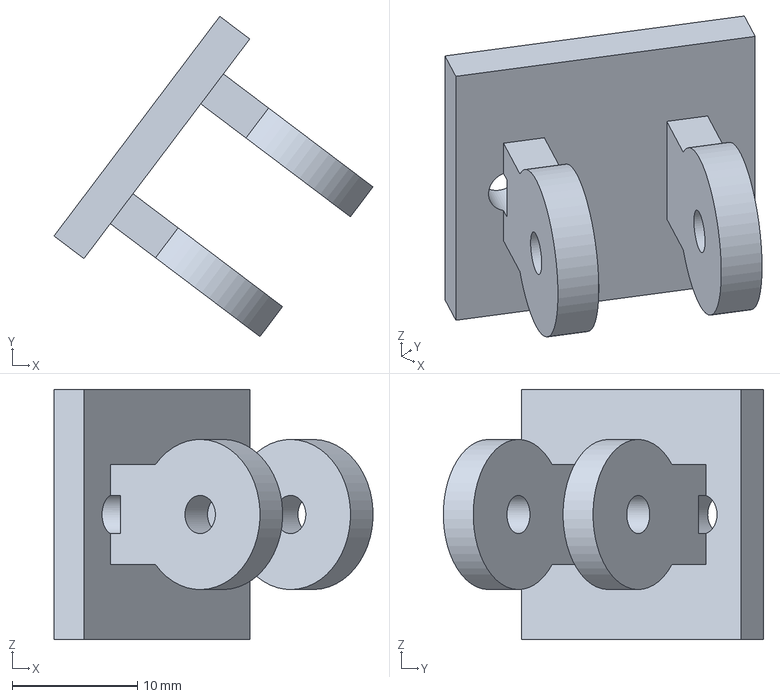
[picture p46: CAD file, 2026-11-09]
docs/candidates/thumb_direct/parts/11_palm_hinge_clevis_interface.step
25.5 x 25.6 x 20.0 mm
