Chiniklas/kinematic_chain/docs/candidates/thumb_direct/parts/pin_D.step

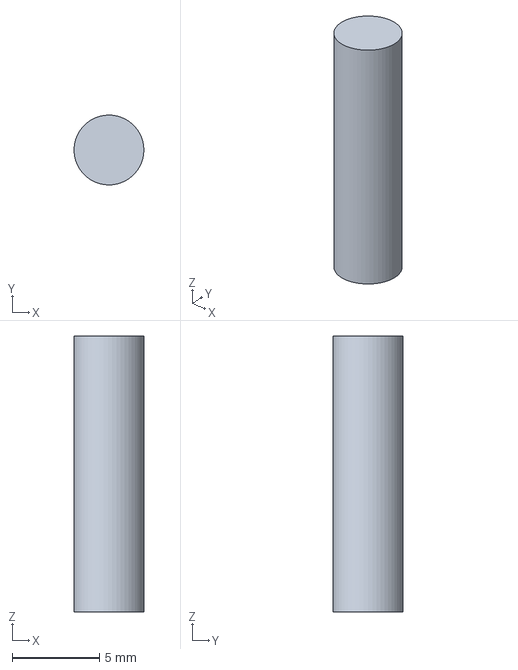
[picture p47: CAD file, 2026-11-09]
docs/candidates/thumb_direct/parts/pin_D.step
4.00 x 4.00 x 15.8 mm
