Chiniklas/kinematic_chain/docs/candidates/thumb_direct/parts/pin_H_direct_R4.step

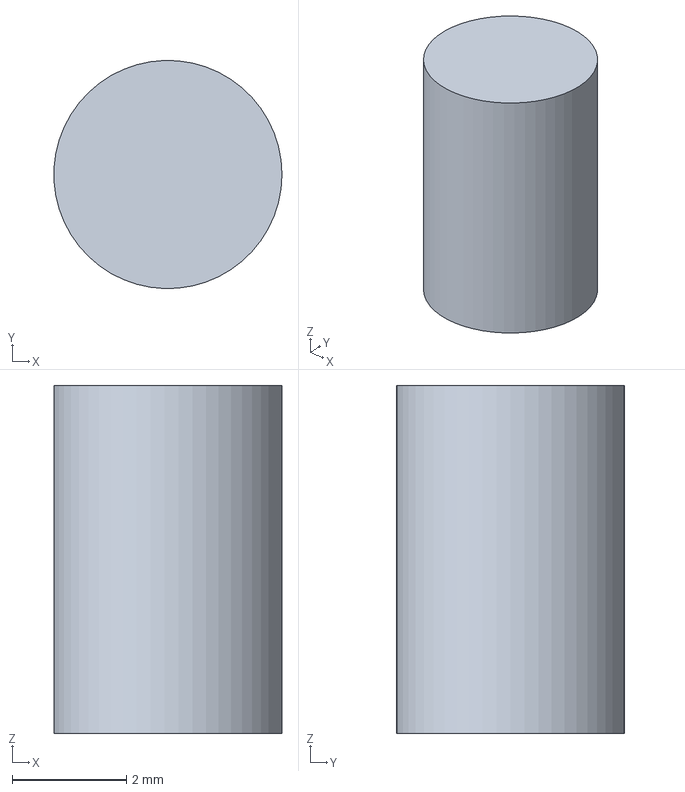
[picture p48: CAD file, 2026-11-09]
docs/candidates/thumb_direct/parts/pin_H_direct_R4.step
4.00 x 4.00 x 6.10 mm
