Chiniklas/kinematic_chain/docs/candidates/thumb_direct/parts/spacer_D.step

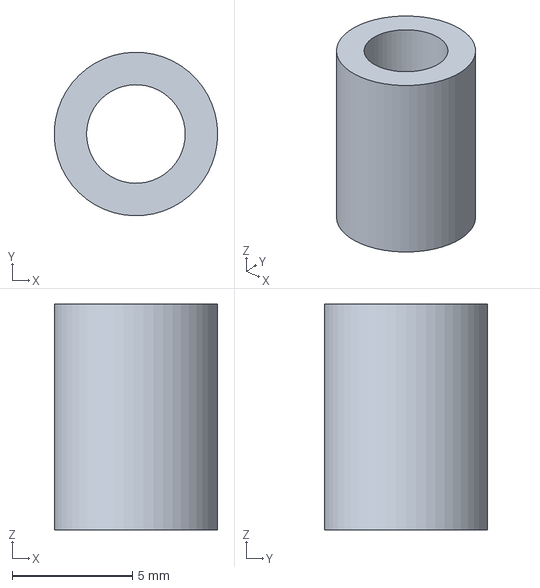
[picture p49: CAD file, 2026-11-09]
docs/candidates/thumb_direct/parts/spacer_D.step
6.79 x 6.80 x 9.40 mm
