Chiniklas/kinematic_chain/docs/candidates/thumb_direct/parts/10_servo_horn_reference.step

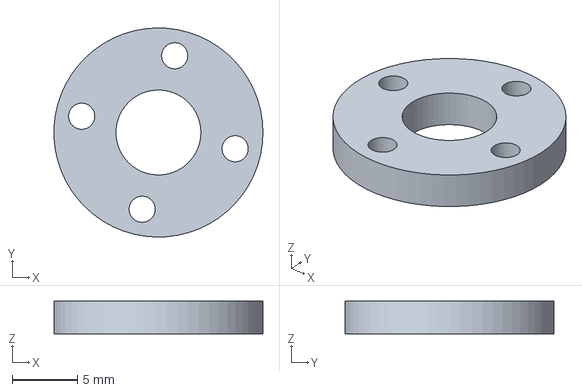
[picture p50: CAD file, 2026-11-09]
docs/candidates/thumb_direct/parts/10_servo_horn_reference.step
16.0 x 16.0 x 2.50 mm
