Chiniklas/kinematic_chain/docs/candidates/thumb_direct/parts/spacer_G.step

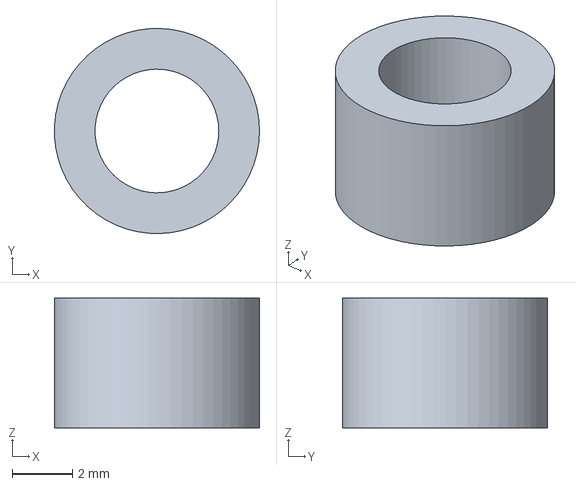
[picture p51: CAD file, 2026-11-09]
docs/candidates/thumb_direct/parts/spacer_G.step
6.79 x 6.80 x 4.30 mm
