Chiniklas/kinematic_chain/docs/candidates/thumb_direct/parts/06_output_FGH.step

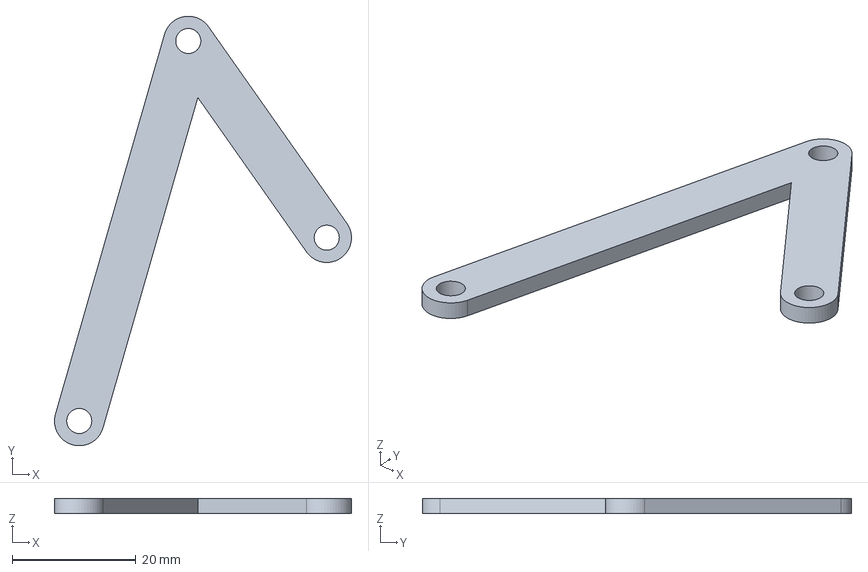
[picture p52: CAD file, 2026-11-09]
docs/candidates/thumb_direct/parts/06_output_FGH.step
48.0 x 69.4 x 2.50 mm
