Chiniklas/kinematic_chain/docs/candidates/thumb_direct/parts/pin_B.step

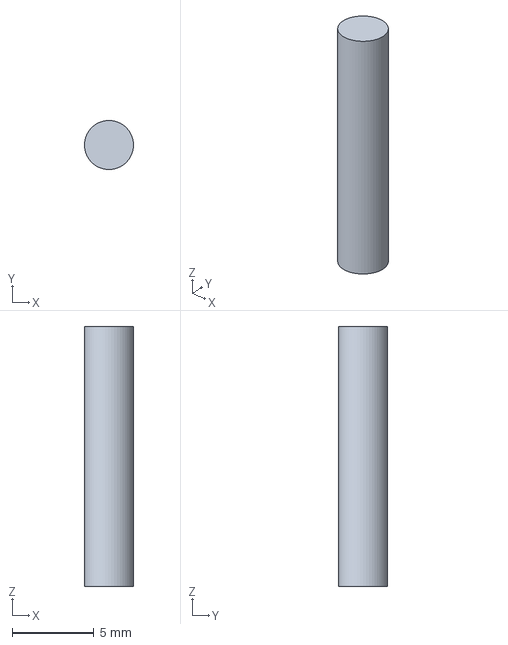
[picture p53: CAD file, 2026-11-09]
docs/candidates/thumb_direct/parts/pin_B.step
3.00 x 3.00 x 15.9 mm
