Chiniklas/kinematic_chain/(list of files, cad)

Other CAD files:
docs/candidates/thumb_direct/parts/motor_standoff_4.step
docs/candidates/thumb_direct/parts/motor_standoff_1.step
docs/candidates/thumb_direct/parts/motor_standoff_2.step
