Chiniklas/kinematic_chain/designs/mechanism_2/nominal/artifacts/combined/combined_workspace_summary.yaml

schema_version: 1
analysis: combined_mechanism_hand_sweep
motion_mapping: normalized_actuator_progress_to_linear_joint_flexion
closure_tolerance_mm: 1.0
rod_length_mm: 28.0
dorsal_clearance_mm: 2.0
optimization_constraint_acceptance: {}
mechanism_requested_q_range_deg:
- 0.0
- 90.0
mechanism_solved_q_range_deg:
- 0.0
- 65.5
mechanism_completed_requested_range: false
fingers:
- finger: index
  contact: fixed_R4_at_upper_distal_midpoint
  horizontal_error_mm: 4.887026
  synchronized_curled_error_mm: 9.832232
  maximum_synchronized_error_mm: 13.734093
  whole_workspace_rod_closure_feasible: false
  samples_within_closure_tolerance_fraction: 0.0
  samples_within_1mm_fraction: 0.0
  best_static_curled_q_deg: 51.5
  best_static_curled_error_mm: 0.006192
  maximum_perpendicular_deviation_deg: 89.048915
  hand_motion:
    progress_bounds_satisfied: true
    monotonic_non_decreasing: true
    terminal_progress: 1.0
    dorsal_flexion_prohibited: true
- finger: middle
  contact: fixed_R4_at_upper_distal_midpoint
  horizontal_error_mm: 13.445302
  synchronized_curled_error_mm: 2.667746
  maximum_synchronized_error_mm: 22.069064
  whole_workspace_rod_closure_feasible: false
  samples_within_closure_tolerance_fraction: 0.0
  samples_within_1mm_fraction: 0.0
  best_static_curled_q_deg: 47.0
  best_static_curled_error_mm: 0.007414
  maximum_perpendicular_deviation_deg: 89.886774
  hand_motion:
    progress_bounds_satisfied: true
    monotonic_non_decreasing: true
    terminal_progress: 1.0
    dorsal_flexion_prohibited: true
- finger: ring
  contact: fixed_R4_at_upper_distal_midpoint
  horizontal_error_mm: 9.27284
  synchronized_curled_error_mm: 4.351177
  maximum_synchronized_error_mm: 17.606154
  whole_workspace_rod_closure_feasible: false
  samples_within_closure_tolerance_fraction: 0.022727
  samples_within_1mm_fraction: 0.022727
  best_static_curled_q_deg: 64.0
  best_static_curled_error_mm: 0.372456
  maximum_perpendicular_deviation_deg: 89.737081
  hand_motion:
    progress_bounds_satisfied: true
    monotonic_non_decreasing: true
    terminal_progress: 1.0
    dorsal_flexion_prohibited: true
- finger: little
  contact: fixed_R4_at_upper_distal_midpoint
  horizontal_error_mm: 3.064245
  synchronized_curled_error_mm: 18.526538
  maximum_synchronized_error_mm: 18.526538
  whole_workspace_rod_closure_feasible: false
  samples_within_closure_tolerance_fraction: 0.166667
  samples_within_1mm_fraction: 0.166667
  best_static_curled_q_deg: 56.0
  best_static_curled_error_mm: 0.41744
  maximum_perpendicular_deviation_deg: 76.56406
  hand_motion:
    progress_bounds_satisfied: true
    monotonic_non_decreasing: true
    terminal_progress: 1.0
    dorsal_flexion_prohibited: true
