Chiniklas/kinematic_chain/(commit log)

2026-07-05 first push
    [torque_samples.csv]
2026-08-08 refactor repo to suit new mechanism optimization and analysis
    [link_lengths.csv, torque_samples.csv]
2026-08-08 updated analysis features
    [torque_samples.csv, workspace_samples.csv]
2026-08-13 extend current pipeline to a exoskeleton-finger coupled optimization, objectives are yet to be determined
    [combined_workspace_samples.csv, history.csv, link_lengths.csv, torque_samples.csv, workspace_samples.csv]
2026-08-23 Increase dorsal clearance to resolve A-palm collision
    dorsal_clearance_mm was 1.0mm, leaving a fixed 1mm penetration between
    the input crank's ground pivot (node A) and the palm capsule at every
    sampled pose, independent of the optimizable link lengths. Raising it
    to 2.0mm closes that gap; the index-finger candidate now passes all
    three hard constraints (collision, rod closure, downward curl).
    [combined_workspace_samples.csv, torque_samples.csv, workspace_samples.csv]
2026-08-25 Record index-finger v1 candidate: lengths, angles, diagrams
    Documents the first hard-constraint-feasible index-finger design found
    after raising dorsal_clearance_mm to 2.0mm (collision, rod-closure, and
    downward-curl all PASS). Includes the 12 link lengths (initial vs
    optimized), node positions and rigid-body interior angles at q=0, plus
    the mechanism diagram, workspace report, and motion animation. The
    underlying runs/ output is gitignored, so this is the permanent record.
    [mechanism.yaml]
2026-09-06 Support a tilted A-D mount and optimise output-rod length
    Mount revision: L_ad 54 -> 21.112 mm sloping 37.054 deg from A to D, and
    dorsal clearance 2.0 -> 7.0 mm. "A-D is horizontal" was hard-coded in four
    places; the mechanism is now solved in the canonical frame and rotated about
    D afterwards, so every assembly-branch selection is unchanged at tilt 0.
    Rod length was absent from the loss entirely, so Adam treated it as a free
    by-product and let it grow. Added it as a weighted design objective, and
    corrected inverted guidance weights: closure, the binding constraint, carried
    1.0 while already-satisfied collision carried 5.0.
    Best index candidate is recorded in docs/candidates/index_finger_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
    [candidate.yaml, mechanism.yaml, mechanism_rod36_alt.yaml, objectives.yaml]
2026-09-06 Split the two A-D mount revisions into selectable design profiles
    The tilted 21.112 mm mount and the original 54 mm horizontal one now live side
    by side instead of overwriting each other, so both can be worked on without
    editing files back and forth:
    ./run_optimization.sh --design long_ad (default, 54 mm horizontal)
    ./run_optimization.sh --design short_ad (21.112 mm at 37.054 deg)
    Each profile owns its nominal design and its optimizer config, and the defaults
    now resolve to long_ad rather than a duplicated top-level copy. The per-finger
    measurement files stay shared.
    This also fixes the breakage the previous commit documented. The nominal design
    is restored to the 54 mm geometry,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
    [mechanism.yaml, objectives.yaml]
2026-09-07 Add analysis tools and retarget long_ad to the extended mount
    The scratch scripts written during the short_ad work kept getting lost and
    rewritten, so the reusable ones now live in tools/ with a README covering what
    each answers:
    design_probe.py geometry, bounds a variable is pinned against, and which
    loop first fails to assemble, with the failing inequality
    collision_report.py which mechanism part hits which hand part, at which pose
    seed_search.py sample, screen, rank with the real evaluator, optimise
    materialize.py a saved vector -> candidate directory, optionally a GIF
    Two traps found the hard way are documented there rather than left in a cha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
    [mechanism.yaml]
2026-09-07 Record the feasible middle-finger design on the extended mount
    long_ad now has a candidate that passes all three hard constraints on the
    71.112 mm mount: rod 31.63 mm, clearance +0.798 mm, closure 0.0774 mm. The
    clearance margin is four times short_ad's, so it tolerates more manufacturing
    error.
    Getting there needed a fresh search rather than an adjustment. The 54 mm
    design's proportions do assemble on the longer frame, but their H path is not
    parallel to the middle finger's R4 path, so no fixed rod length closes it -
    three rounds of angle and weight sweeps all stalled around 5 mm of closure
    error. tools/seed_search.py found the working start.
    Worth noting for later runs: the successful se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
    [candidate.yaml, mechanism.yaml]
2026-09-07 Correct the long mount: 50 mm is a horizontal offset, not an A-D length
    The two variants sit 50 mm apart horizontally at the same A height; the A-D
    members themselves differ by 46.94 mm. An earlier revision took the 50 mm as a
    length difference and built long_ad on L_ad = 71.112 mm.
    That 3 mm error was not cosmetic. Re-evaluating the design built on the wrong
    frame at the correct 68.0485 mm drops it from 3/3 to 1/3 - clearance -1.529 mm,
    closure 5.67 mm. The feasible region is narrow enough that the frame has to be
    right before anything downstream is worth tuning, so the search was rerun.
    The adopted candidate passes all three constraints with a 35.49 mm rod and
    +0.803 mm of clearance. doc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
    [candidate.yaml, mechanism.yaml, objectives.yaml]
2026-11-09 Add direct-drive thumb linkage optimization and CAD
